codeman-pi-projects/GBA_SPi_Board/GBA SP schematic.pdf

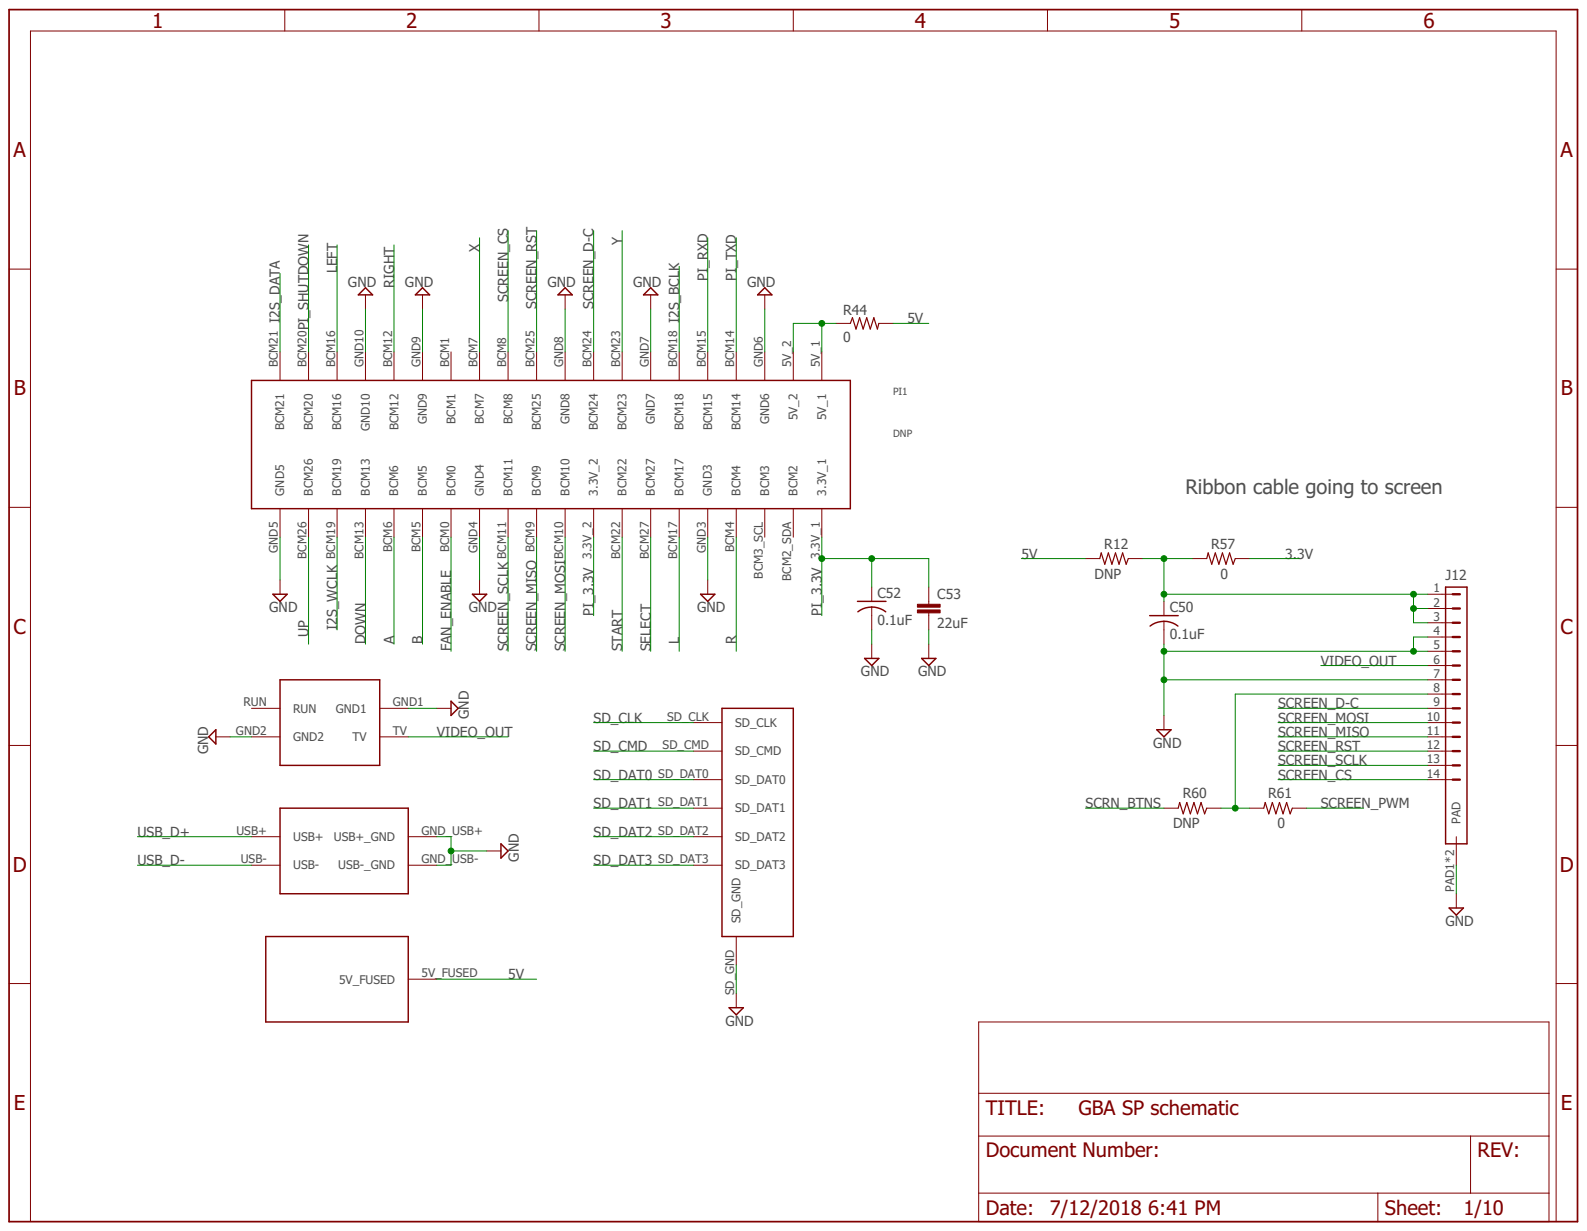
[picture p1: page 1]

Ribbon cable going to screen

Document Number: | REV:

Date: 7/12/2018 6:41 PM | Sheet: 1/10

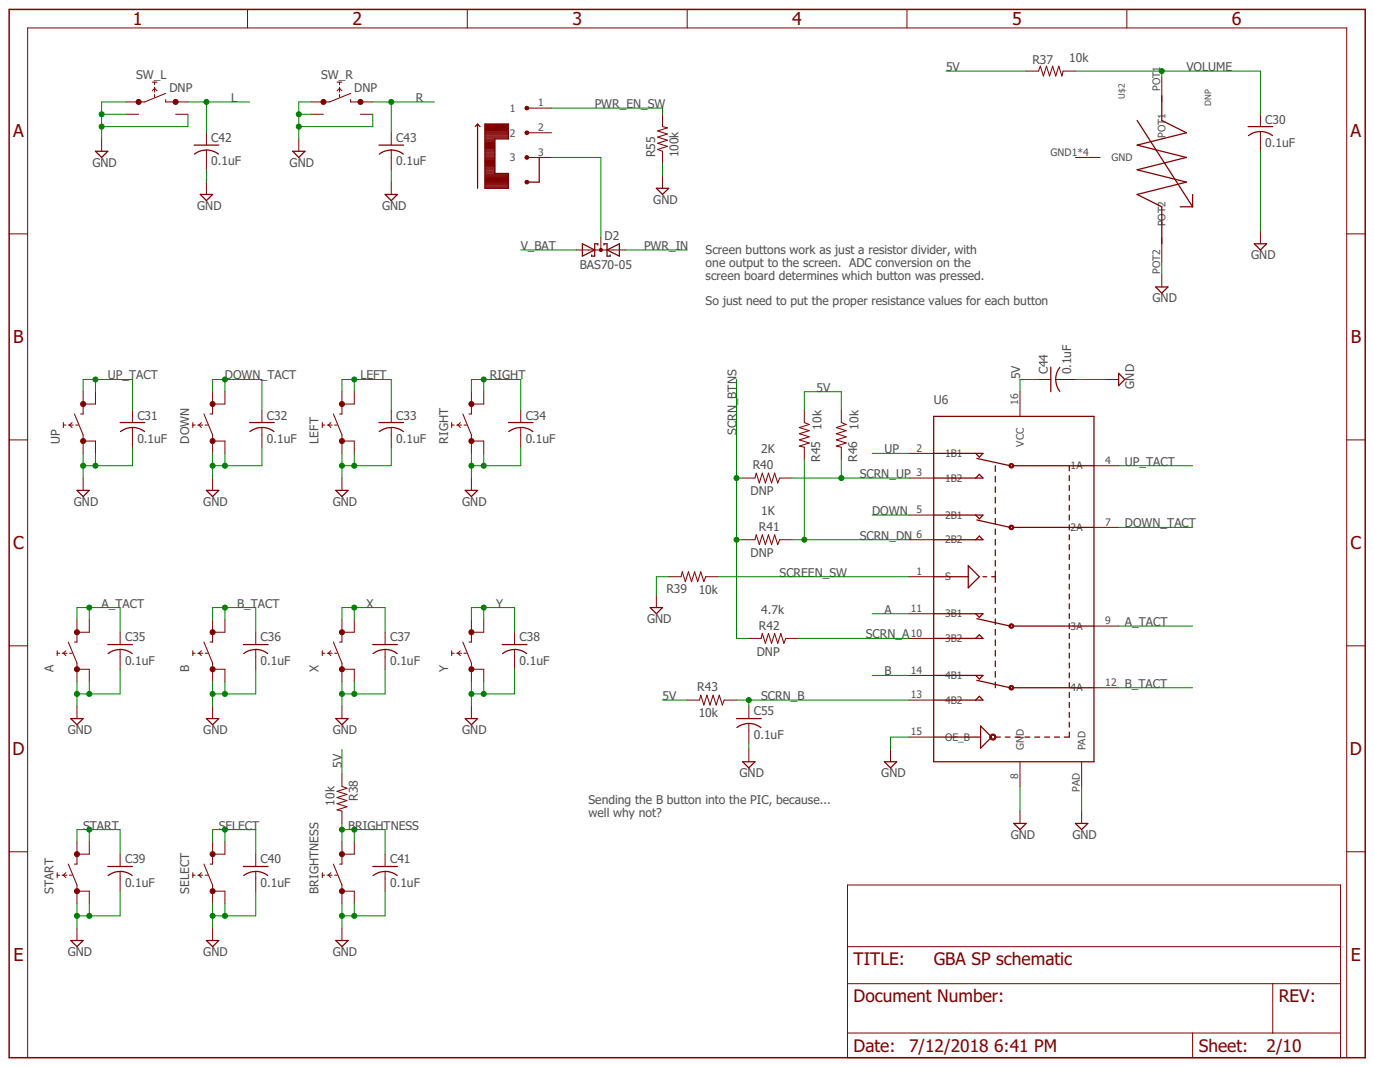
[picture p2: page 2]

Screen buttons work as just a resistor divider, with
one output to the screen. ADC conversion on the
screen board determines which button was pressed. So just need to put the proper resistance values for each button

Sending the B button into the PIC, because... well why not?

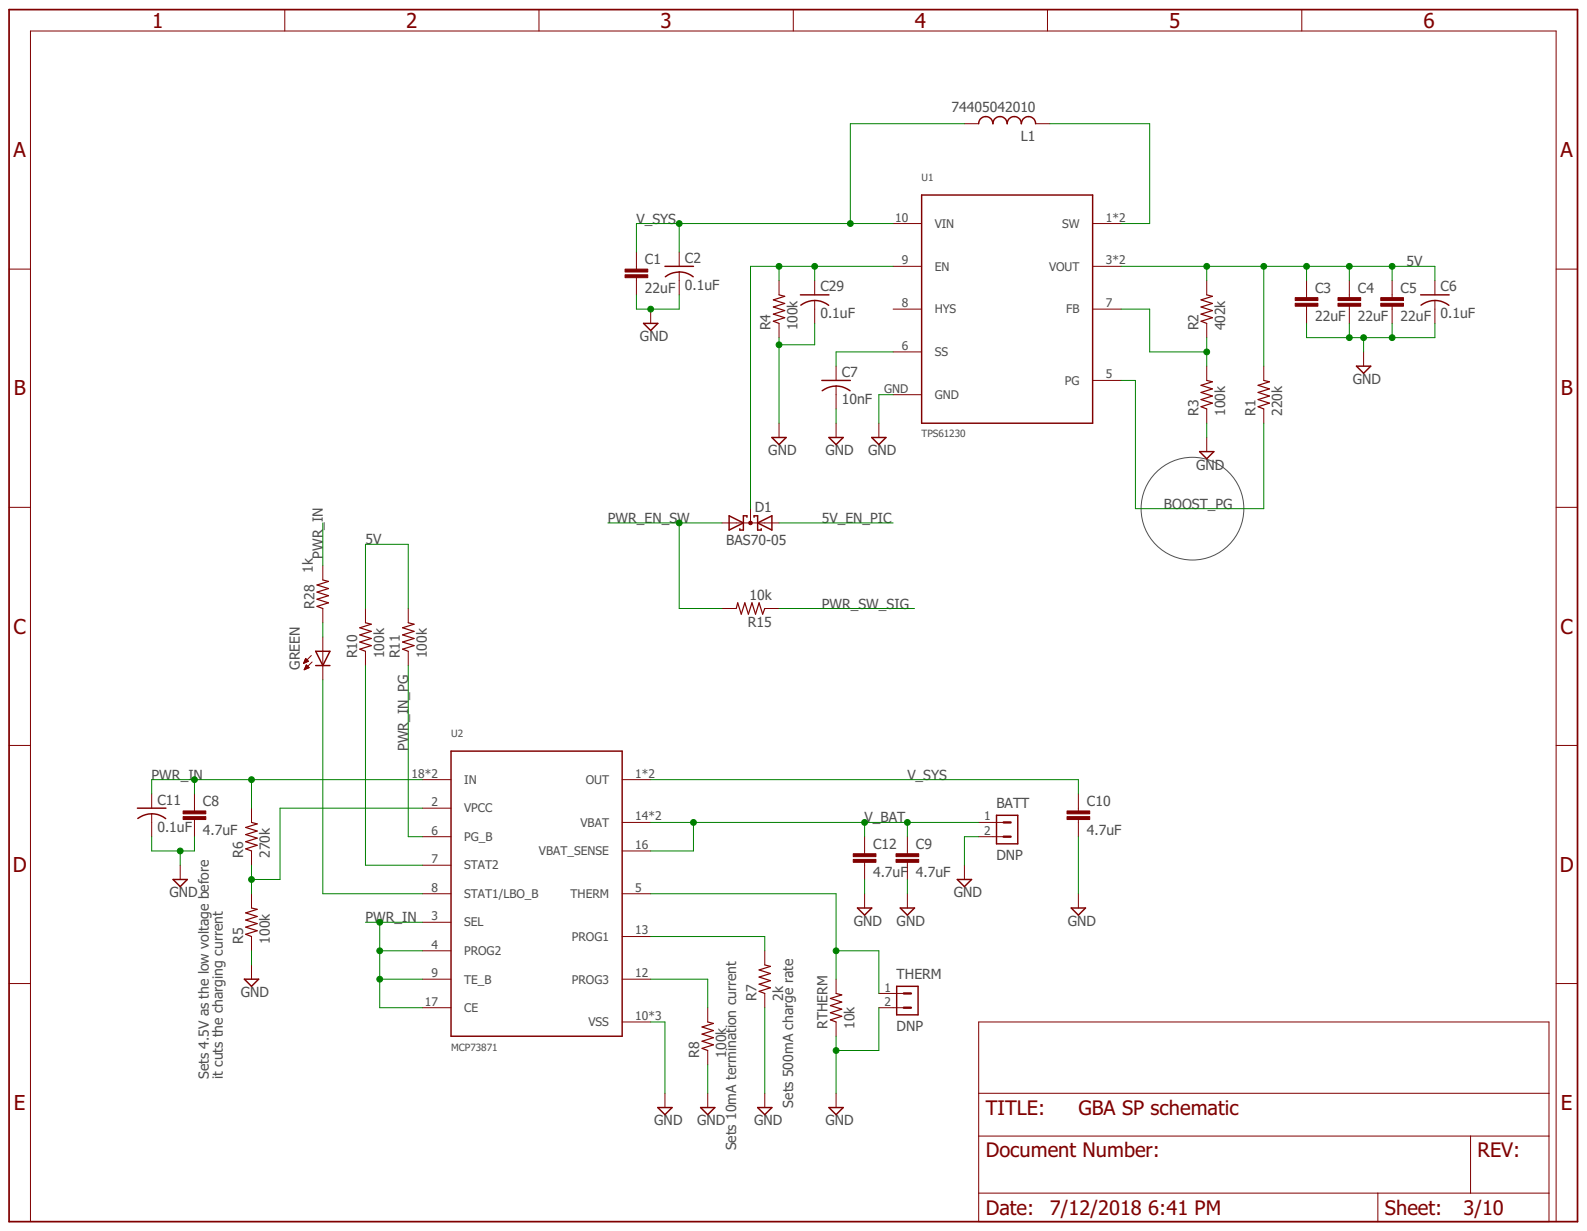
[picture p3: page 3]

Sets 4.5V as the low voltage before

it cuts the charging current

Sets 500mA charge rate Sets 10mA termination current

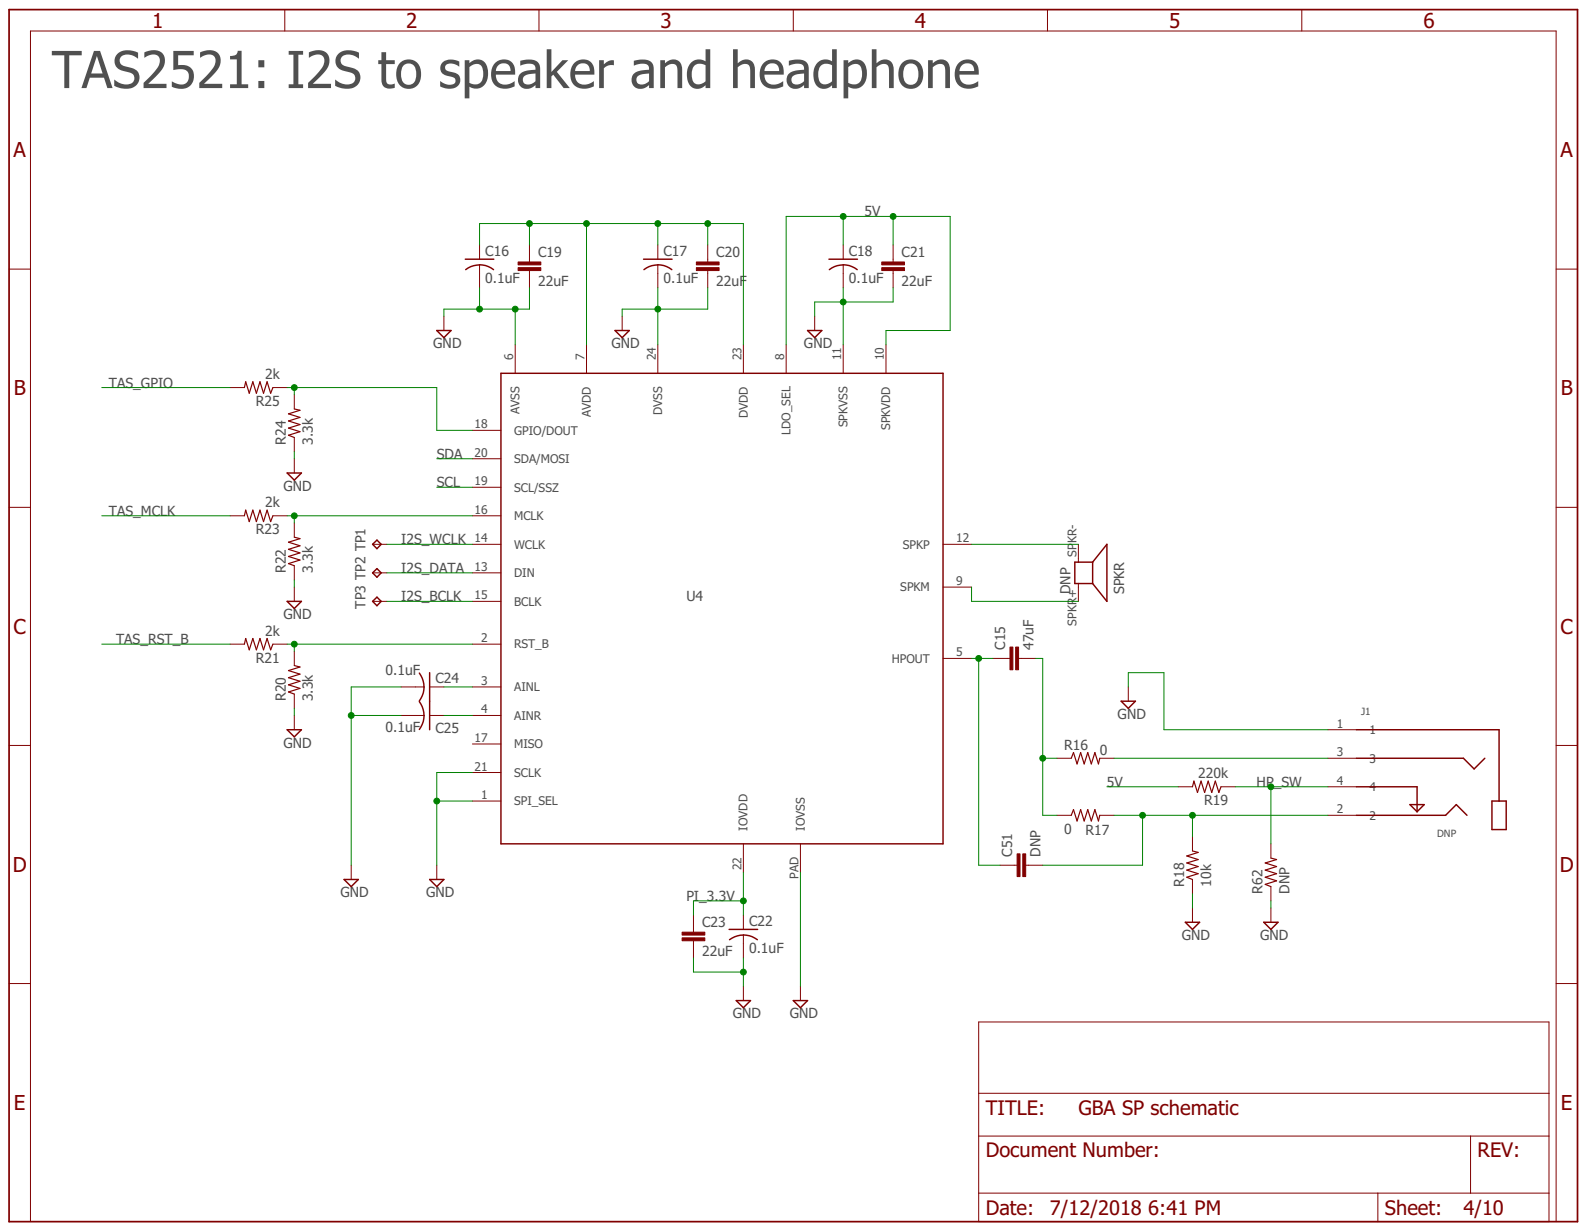
[picture p4: page 4]

TAS2521: I2S to speaker and headphone

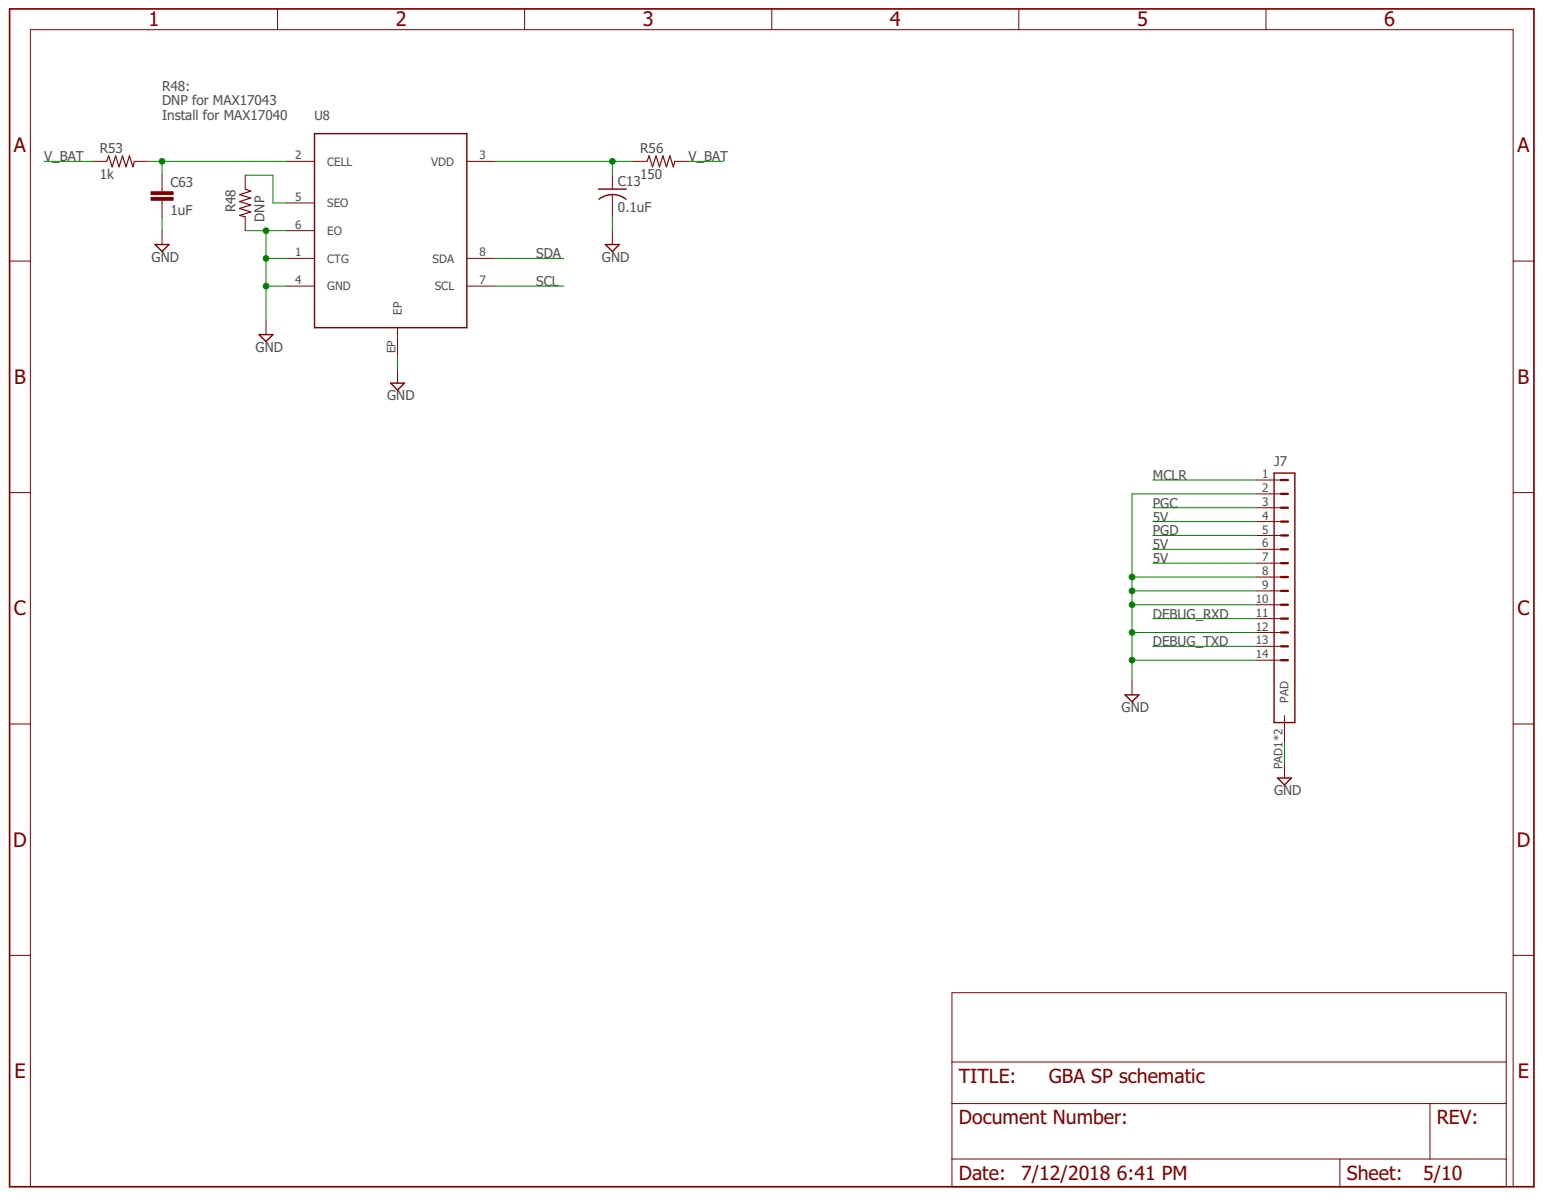
[picture p5: page 5]

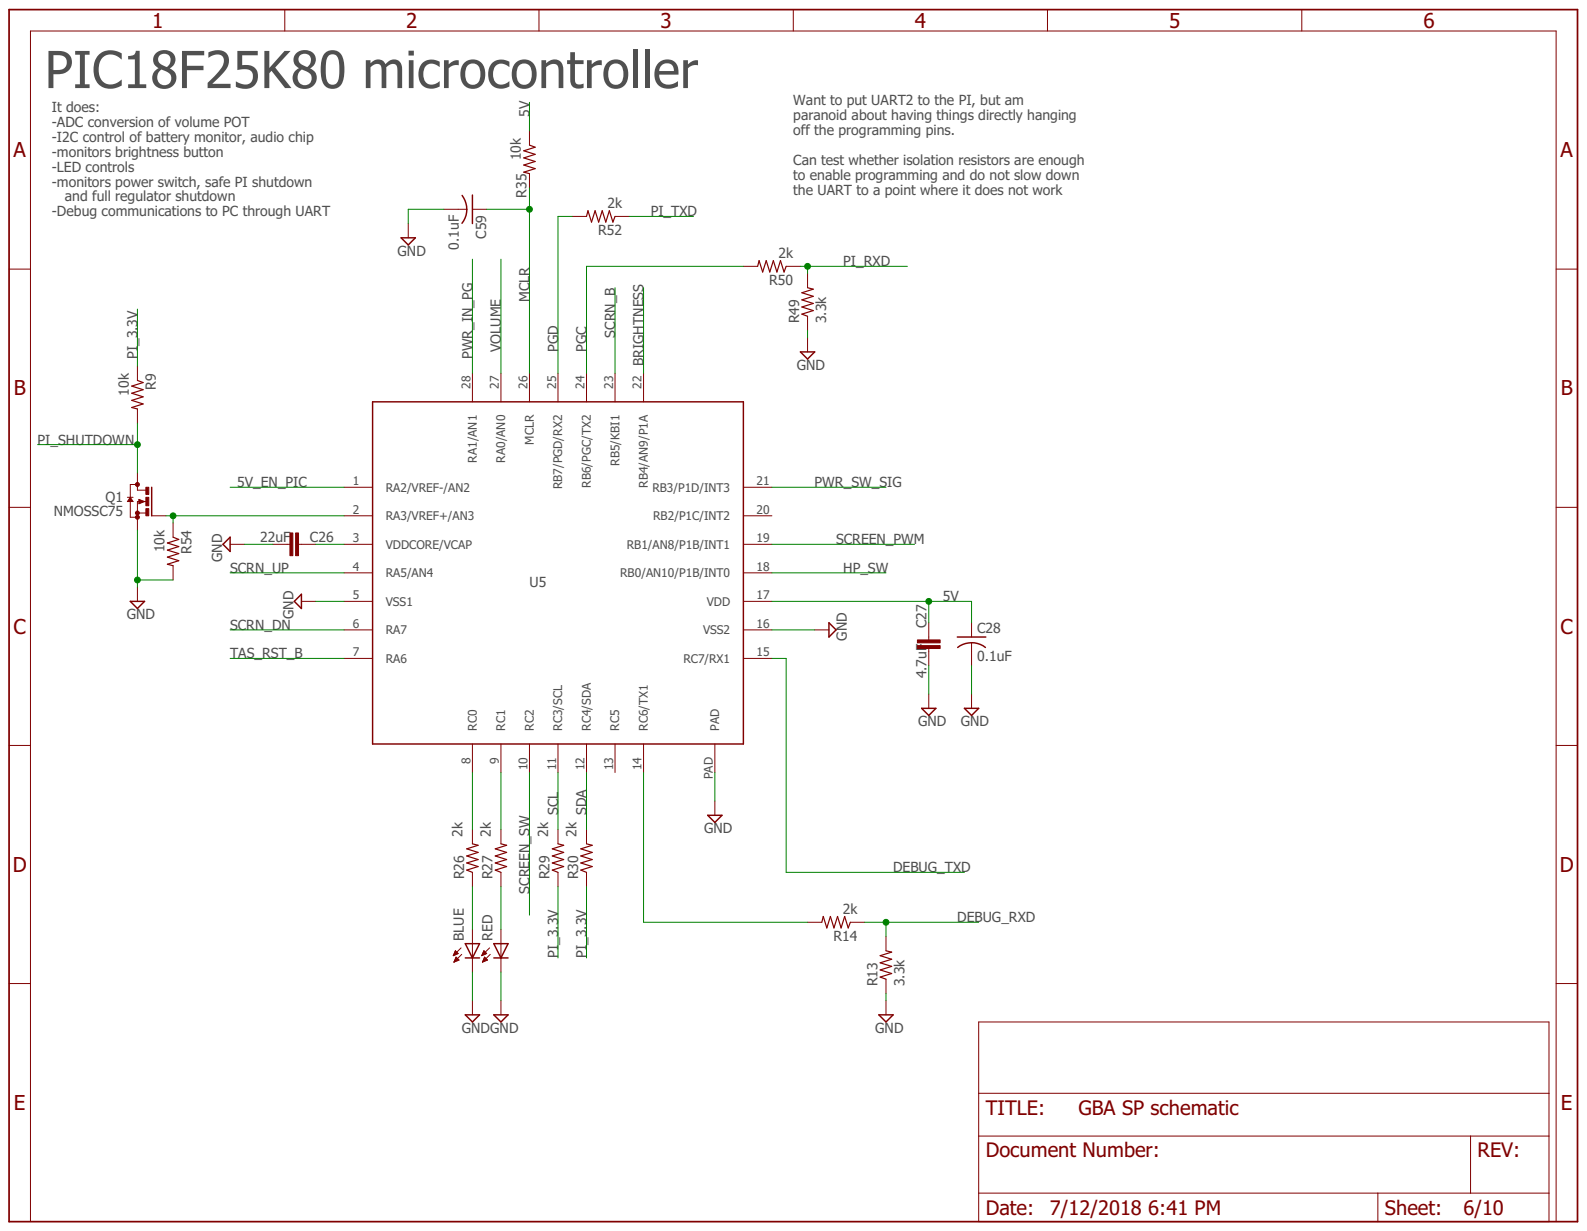
[picture p6: page 6]

Want to put UART2 to the PI, but am
paranoid about having things directly hanging
off the programming pins. Can test whether isolation resistors are enough

It does: -ADC conversion of volume POT

-I2C control of battery monitor, audio chip

-monitors brightness button
-LED controls
-monitors power switch, safe PI shutdown
and full regulator shutdown
-Debug communications to PC through UART

to enable programming and do not slow down
the UART to a point where it does not work

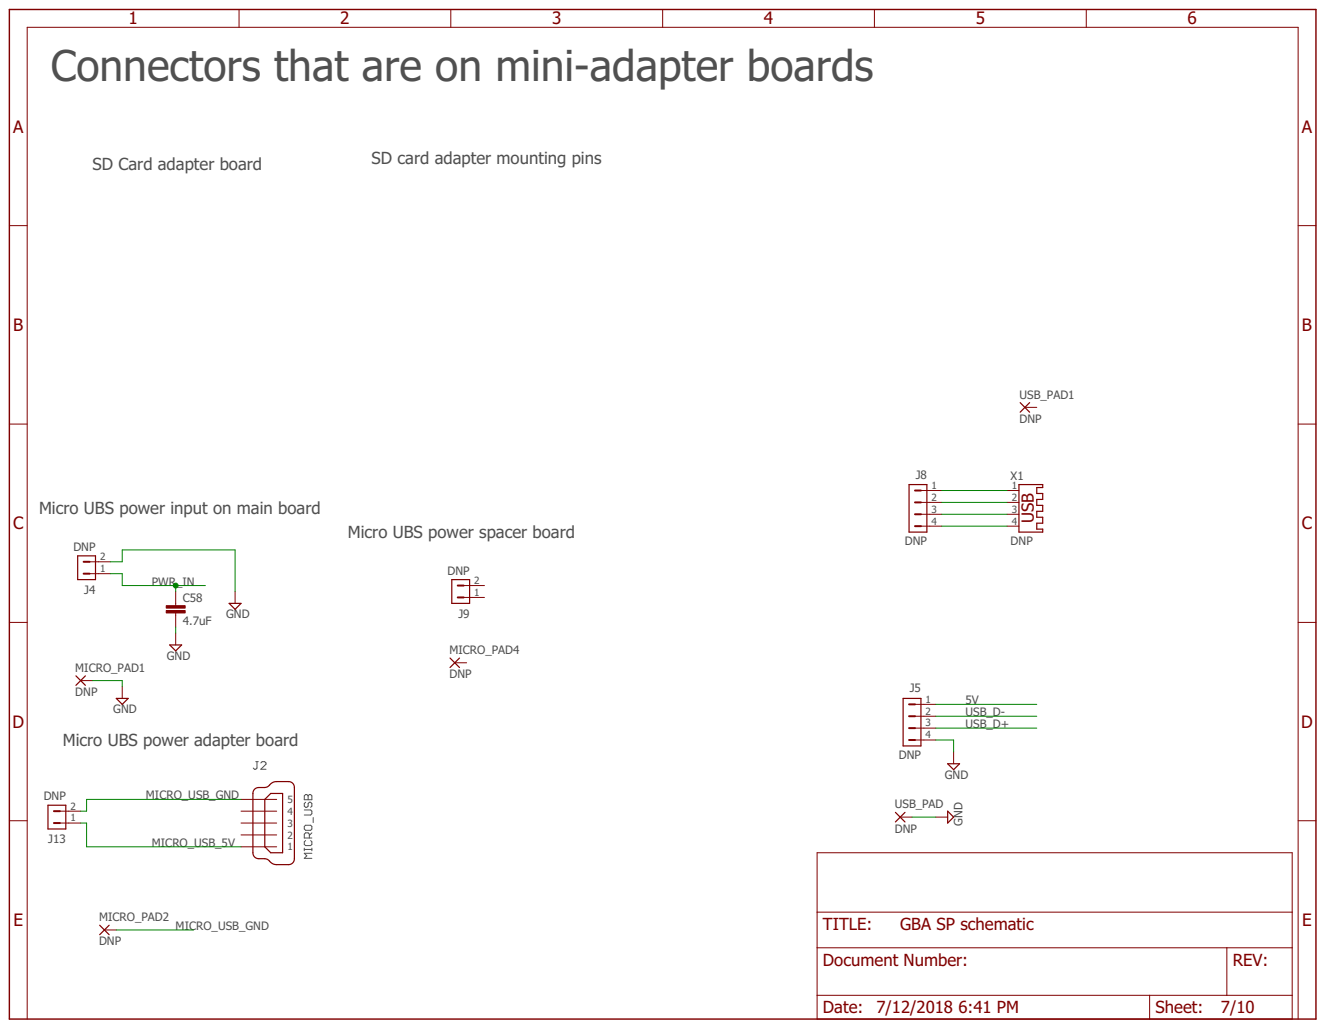
[picture p7: page 7]

Connectors that are on mini-adapter boards

Micro UBS power input on main board

Micro UBS power spacer board

Micro UBS power adapter board

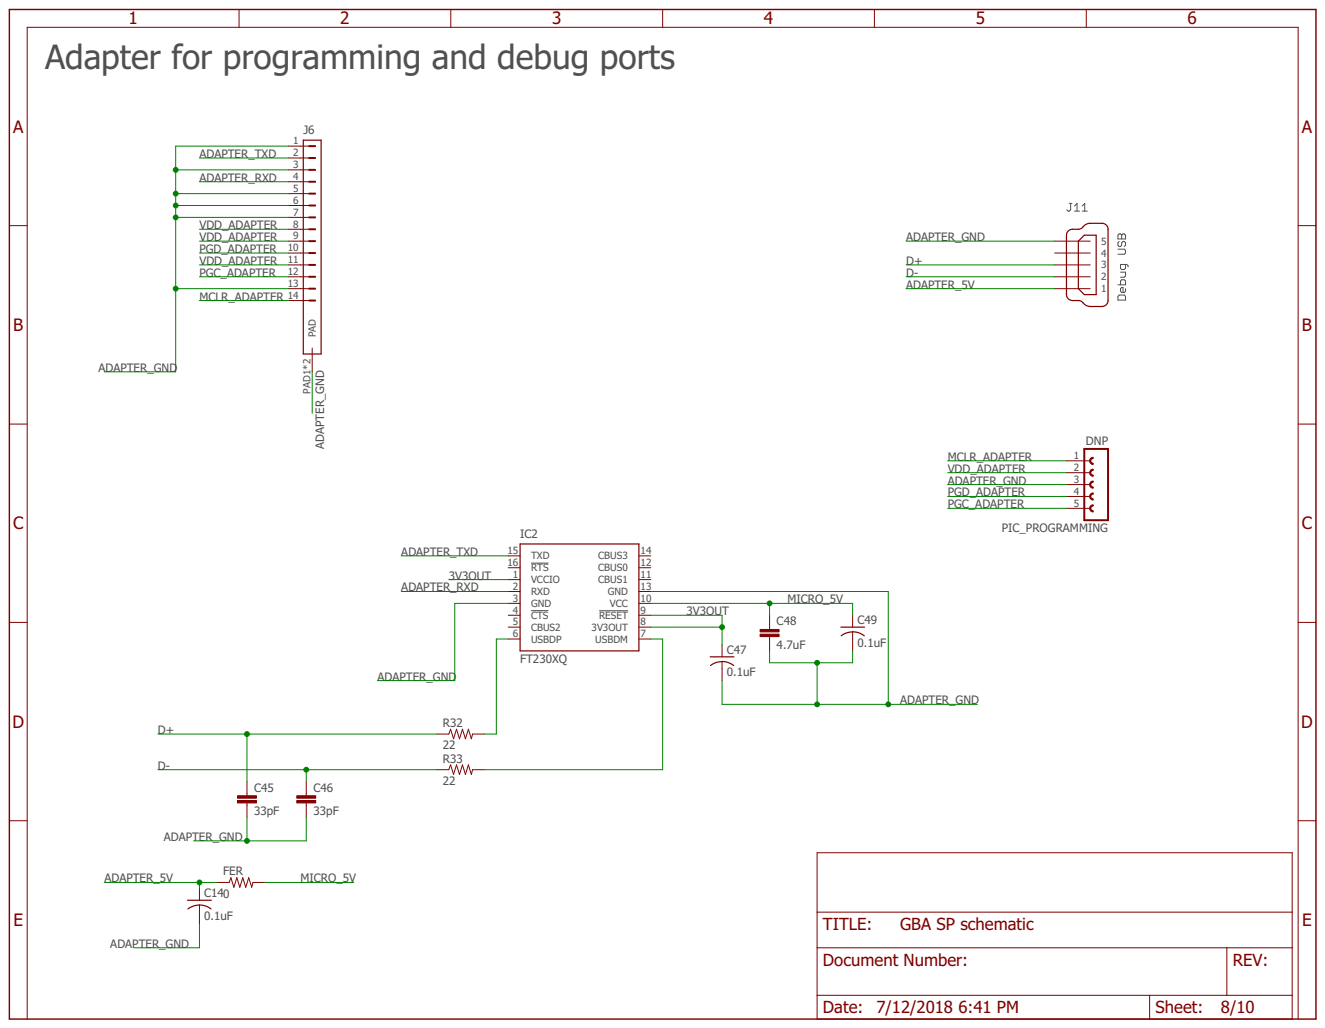
[picture p8: page 8]

Adapter for programming and debug ports

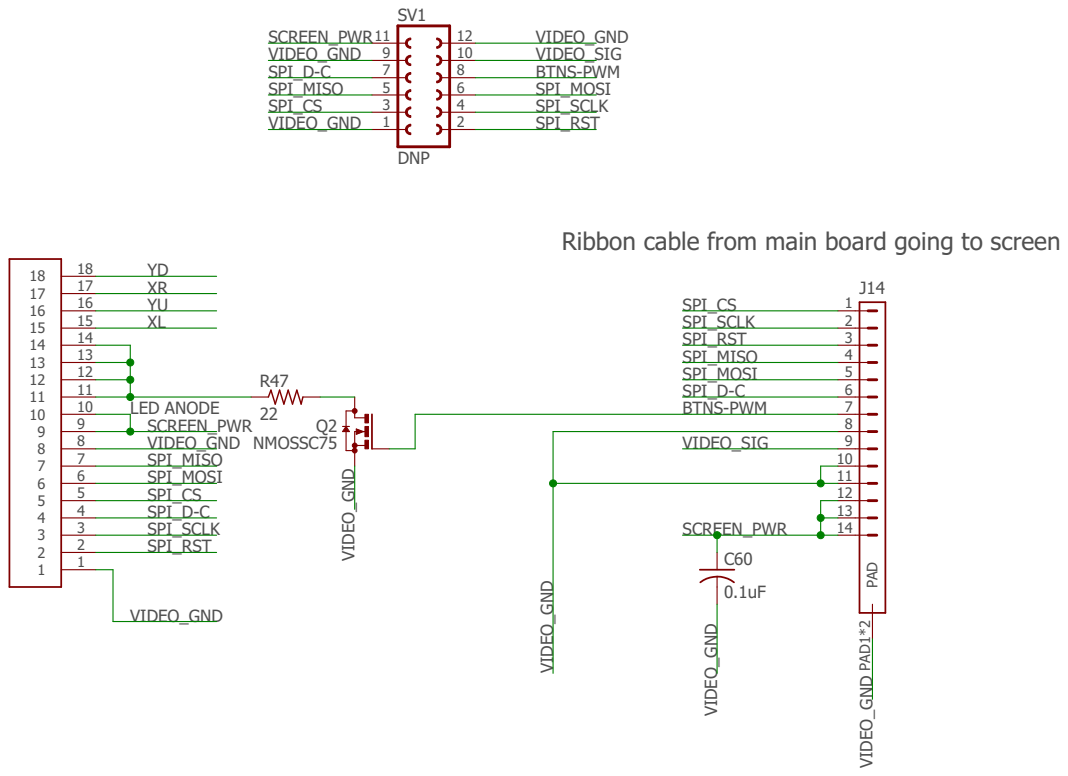
[picture p9: page 9]

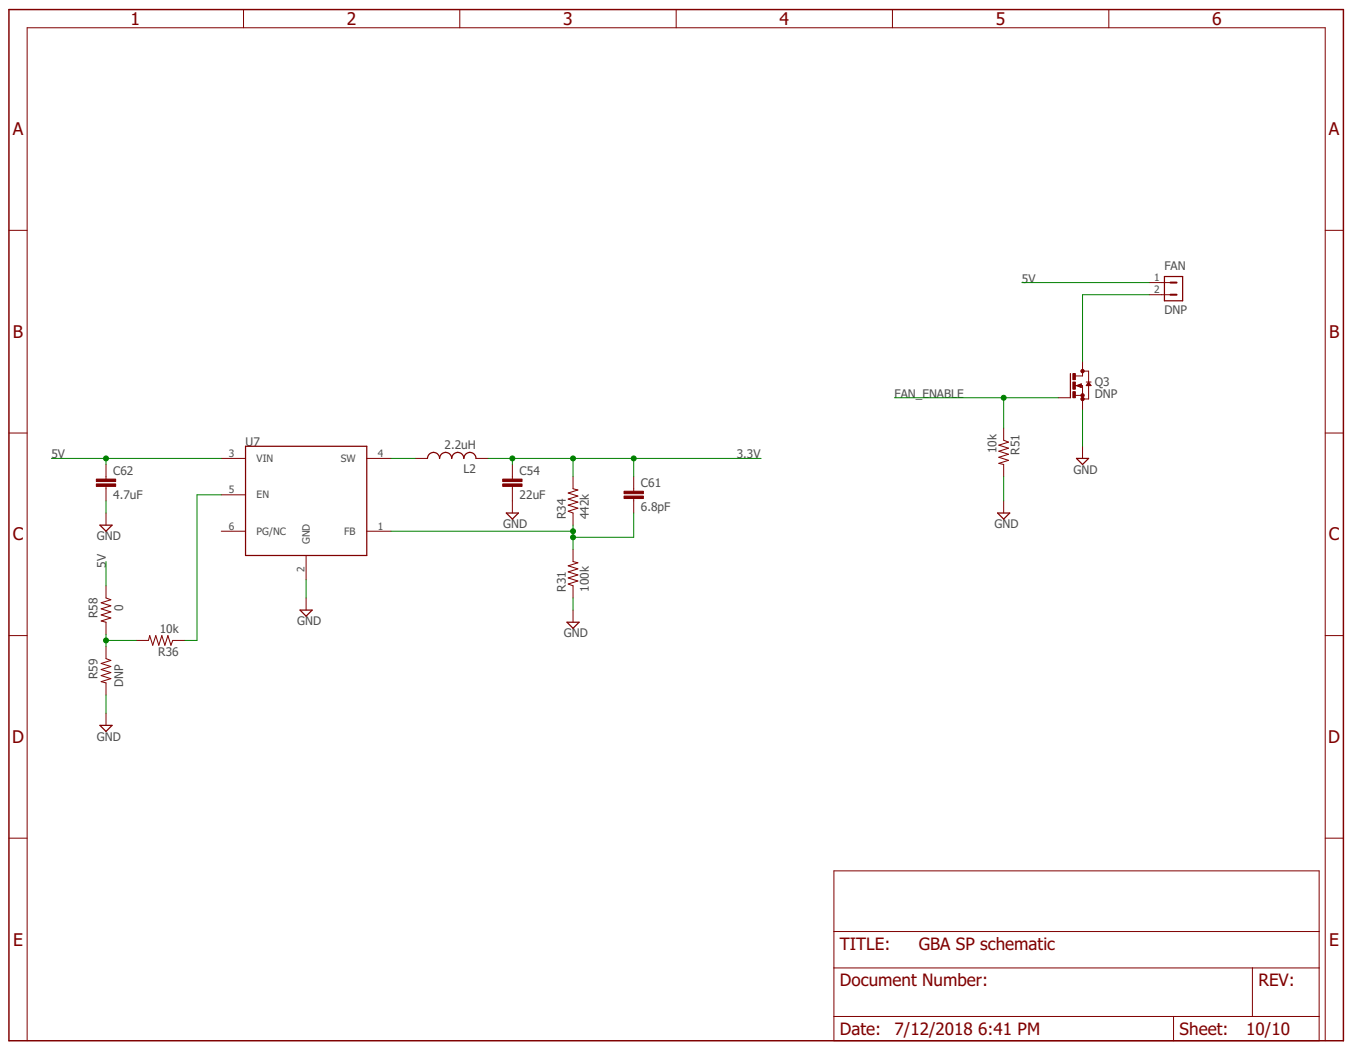
[picture p10: page 10]
