codeman-pi-projects/GBA_SPi_Board/GBA SP schematic.brd

## EAGLE design GBA SP schematic.brd (2018-10-27)

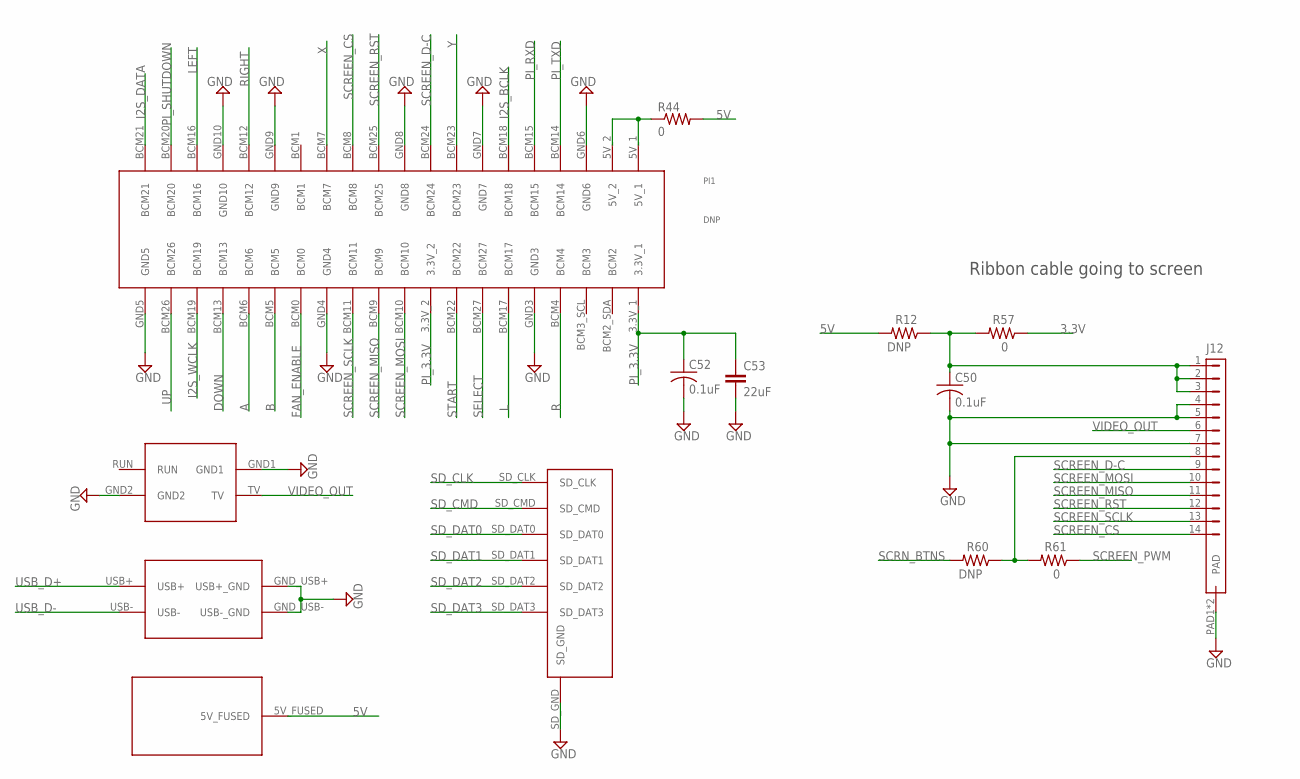
[picture p11: schematic GBA SP schematic.sch, sheet 1]

Parts:
C50, C52: 0.1uF; 0402_REAL; MPN CC0603ZRY5V9BB104; DIGIKEY 311-1343-1-ND
C53: 22uF; C0805; MPN LMK212BBJ226MG-T; DIGIKEY 587-5464-1-ND
J12: FPC_14; MPN 5051101492; DIGIKEY WM12370CT-ND
PI1: DNP; PI-ZERO
R12: DNP; R0603
R44: 0; R0805
R57: 0; R0603
R60: DNP; 0402_REAL
R61: 0; 0402_REAL

Connections:
3.3V: R57.1; also elsewhere on the board
5V: PI1.5V_FUSED, R12.2, R44.2; also elsewhere on the board
A: PI1.BCM6; also elsewhere on the board
B: PI1.BCM5; also elsewhere on the board
DOWN: PI1.BCM13; also elsewhere on the board
FAN_ENABLE: PI1.BCM0; also elsewhere on the board
GND: C50.2, C52.2, C53.2, J12.4, J12.5, J12.7, J12.PAD1 (PAD), J12.PAD2 (PAD), PI1.GND1, PI1.GND2, PI1.GND3, PI1.GND4, PI1.GND5, PI1.GND6, PI1.GND7, PI1.GND8, PI1.GND9, PI1.GND10, PI1.GND_USB+ (USB+_GND), PI1.GND_USB- (USB-_GND), PI1.SD_GND; also elsewhere on the board
I2S_BCLK: PI1.BCM18; also elsewhere on the board
I2S_DATA: PI1.BCM21; also elsewhere on the board
I2S_WCLK: PI1.BCM19; also elsewhere on the board
L: PI1.BCM17; also elsewhere on the board
LEFT: PI1.BCM16; also elsewhere on the board
unnamed: PI1.5V_1, PI1.5V_2, R44.1
unnamed: J12.8, R60.1, R61.2
unnamed: C50.1, J12.1, J12.2, J12.3, R12.1, R57.2
PI_3.3V: C52.1, C53.1, PI1.3.3V_1, PI1.3.3V_2; also elsewhere on the board
PI_RXD: PI1.BCM15; also elsewhere on the board
PI_SHUTDOWN: PI1.BCM20; also elsewhere on the board
PI_TXD: PI1.BCM14; also elsewhere on the board
R: PI1.BCM4; also elsewhere on the board
RIGHT: PI1.BCM12; also elsewhere on the board
SCREEN_CS: J12.14, PI1.BCM8
SCREEN_D-C: J12.9, PI1.BCM24
SCREEN_MISO: J12.11, PI1.BCM9
SCREEN_MOSI: J12.10, PI1.BCM10
SCREEN_PWM: R61.1; also elsewhere on the board
SCREEN_RST: J12.12, PI1.BCM25
SCREEN_SCLK: J12.13, PI1.BCM11
SCRN_BTNS: R60.2; also elsewhere on the board
SD_CLK: PI1.SD_CLK
SD_CMD: PI1.SD_CMD
SD_DAT0: PI1.SD_DAT0
SD_DAT1: PI1.SD_DAT1
SD_DAT2: PI1.SD_DAT2
SD_DAT3: PI1.SD_DAT3
SELECT: PI1.BCM27; also elsewhere on the board
START: PI1.BCM22; also elsewhere on the board
UP: PI1.BCM26; also elsewhere on the board
USB_D+: PI1.USB+; also elsewhere on the board
USB_D-: PI1.USB-; also elsewhere on the board
VIDEO_OUT: J12.6, PI1.TV
X: PI1.BCM7; also elsewhere on the board
Y: PI1.BCM23; also elsewhere on the board

Notes on the sheet:
Ribbon cable going to screen

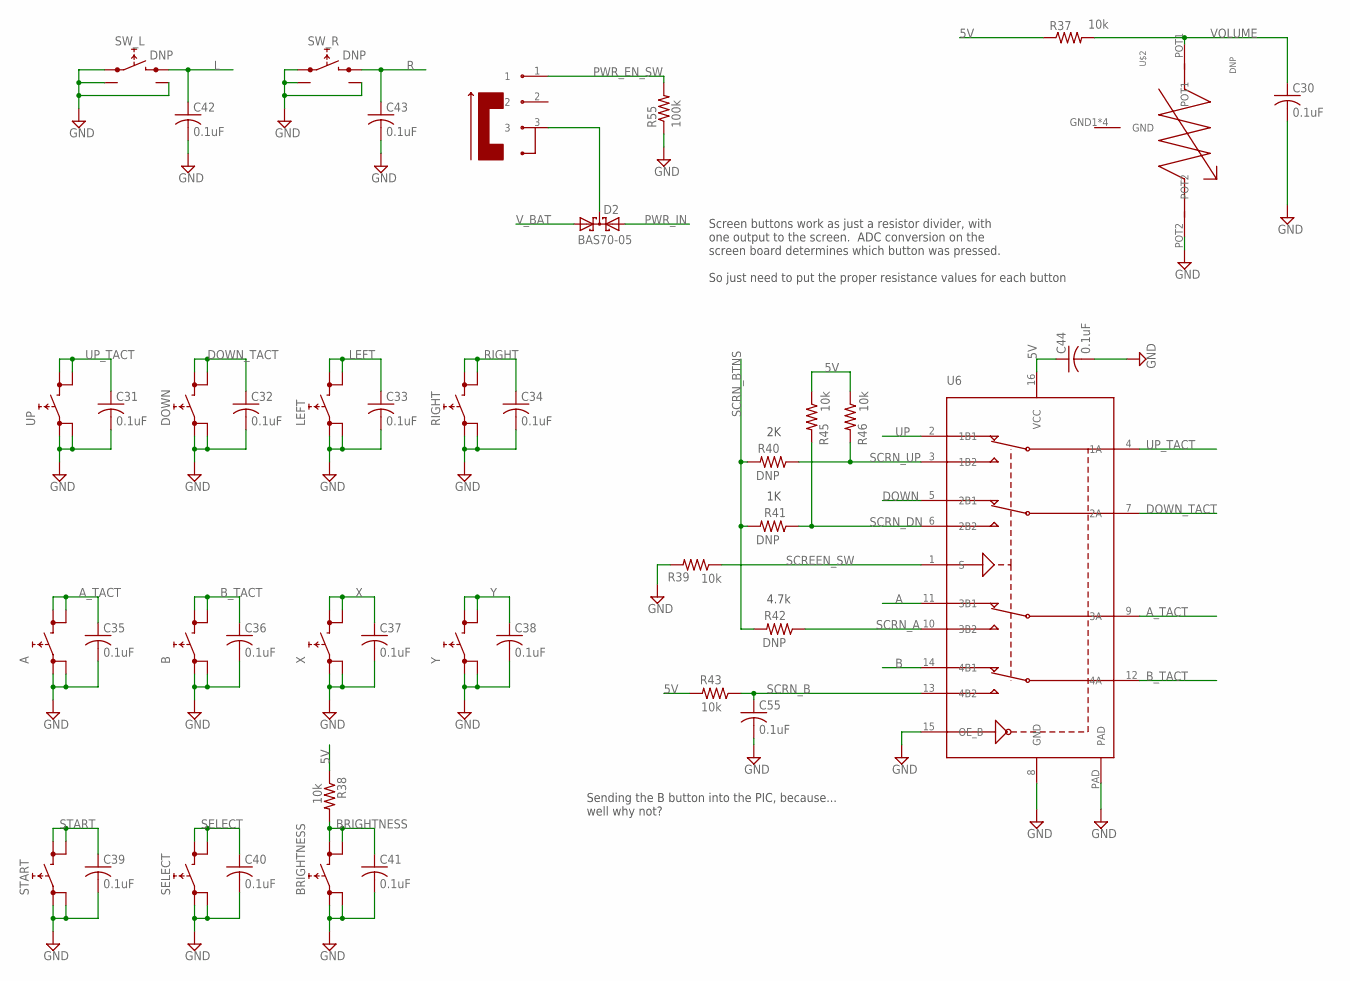
[picture p12: schematic GBA SP schematic.sch, sheet 2]

Parts:
A: TACTILEGBA_SP; GBA_SP_TACT; MPN SKRRAAE010; MOUSER 688-SKRRAA
B: TACTILEGBA_SP; GBA_SP_TACT; MPN SKRRAAE010; MOUSER 688-SKRRAA
BRIGHTNESS: TACTILE; TL3315; MPN TL3315NF160Q; DIGIKEY EG4621CT-ND
C30, C31, C32, C33, C34, C35, C36, C37, C38, C39, C40, C41, C42, C43, C44, C55: 0.1uF; 0402_REAL; MPN CC0603ZRY5V9BB104; DIGIKEY 311-1343-1-ND
D2: BAS70-05; SOT23; MPN BAS70-05-E3-08; DIGIKEY BAS70-05-E3-08CT-ND
DOWN: TACTILEGBA_SP; GBA_SP_TACT; MPN SKRRAAE010; MOUSER 688-SKRRAA
LEFT: TACTILEGBA_SP; GBA_SP_TACT; MPN SKRRAAE010; MOUSER 688-SKRRAA
R37, R38, R39, R43, R45, R46: 10k; 0402_REAL
R40: DNP; 0402_REAL; MPN ERJ-2RKF2001X; DIGIKEY P2.00KLCT-ND
R41, R42: DNP; 0402_REAL
R55: 100k; 0402_REAL; MPN RC0402FR-07100KL; DIGIKEY 311-100KLRCT-ND
RIGHT: TACTILEGBA_SP; GBA_SP_TACT; MPN SKRRAAE010; MOUSER 688-SKRRAA
SELECT: TACTILE; TL3315; MPN TL3315NF160Q; DIGIKEY EG4621CT-ND
START: TACTILE; TL3315; MPN TL3315NF160Q; DIGIKEY EG4621CT-ND
SW_L: DNP; GBA-SHOULDER-SW
SW_R: DNP; GBA-SHOULDER-SW
U6: SN74CBT3257C; VQFN16; MPN SN74CBT3257CRGYR; DIGIKEY 296-19212-1-ND
U$1: CSS-1210; MPN CSS-1210TB
U$2: DNP; GBA-POT
UP: TACTILEGBA_SP; GBA_SP_TACT; MPN SKRRAAE010; MOUSER 688-SKRRAA
X: TACTILEGBA_SP; GBA_SP_TACT; MPN SKRRAAE010; MOUSER 688-SKRRAA
Y: TACTILEGBA_SP; GBA_SP_TACT; MPN SKRRAAE010; MOUSER 688-SKRRAA

Connections:
5V: C44.1, R37.1, R38.1, R43.2, R45.1, R46.1, U6.16 (VCC); also elsewhere on the board
A: U6.11 (3B1); also elsewhere on the board
A_TACT: A.2 (3), A.4, C35.1, U6.9 (3A)
B: U6.14 (4B1); also elsewhere on the board
BRIGHTNESS: BRIGHTNESS.3, BRIGHTNESS.4, C41.1, R38.2; also elsewhere on the board
B_TACT: B.2 (3), B.4, C36.1, U6.12 (4A)
DOWN: U6.5 (2B1); also elsewhere on the board
DOWN_TACT: C32.1, DOWN.2 (3), DOWN.4, U6.7 (2A)
GND: A.1, A.3 (2), B.1, B.3 (2), BRIGHTNESS.1, BRIGHTNESS.2, C30.2, C31.2, C32.2, C33.2, C34.2, C35.2, C36.2, C37.2, C38.2, C39.2, C40.2, C41.2, C42.2, C43.2, C44.2, C55.2, DOWN.1, DOWN.3 (2), LEFT.1, LEFT.3 (2), R39.2, R55.1, RIGHT.1, RIGHT.3 (2), SELECT.1, SELECT.2, START.1, START.2, SW_L.A, SW_L.GND1, SW_L.GND2, SW_R.A, SW_R.GND1, SW_R.GND2, U6.8 (GND), U6.15 (OE_B), U6.PAD, U$2.POT2, UP.1, UP.3 (2), X.1, X.3 (2), Y.1, Y.3 (2); also elsewhere on the board
L: C42.1, SW_L.B; also elsewhere on the board
LEFT: C33.1, LEFT.2 (3), LEFT.4; also elsewhere on the board
unnamed: D2.3 (C), U$1.3
PWR_EN_SW: R55.2, U$1.1; also elsewhere on the board
PWR_IN: D2.2 (A2); also elsewhere on the board
R: C43.1, SW_R.B; also elsewhere on the board
RIGHT: C34.1, RIGHT.2 (3), RIGHT.4; also elsewhere on the board
SCREEN_SW: R39.1, U6.1 (S); also elsewhere on the board
SCRN_A: R42.1, U6.10 (3B2)
SCRN_B: C55.1, R43.1, U6.13 (4B2); also elsewhere on the board
SCRN_BTNS: R40.2, R41.2, R42.2; also elsewhere on the board
SCRN_DN: R41.1, R45.2, U6.6 (2B2); also elsewhere on the board
SCRN_UP: R40.1, R46.2, U6.3 (1B2); also elsewhere on the board
SELECT: C40.1, SELECT.3, SELECT.4; also elsewhere on the board
START: C39.1, START.3, START.4; also elsewhere on the board
UP: U6.2 (1B1); also elsewhere on the board
UP_TACT: C31.1, U6.4 (1A), UP.2 (3), UP.4
VOLUME: C30.1, R37.2, U$2.POT1; also elsewhere on the board
V_BAT: D2.1 (A1); also elsewhere on the board
X: C37.1, X.2 (3), X.4; also elsewhere on the board
Y: C38.1, Y.2 (3), Y.4; also elsewhere on the board

Notes on the sheet:
Screen buttons work as just a resistor divider, with one output to the screen. ADC conversion on the screen board determines which button was pressed. So just need to put the proper resistance values for each button
Sending the B button into the PIC, because... well why not?
4.7k

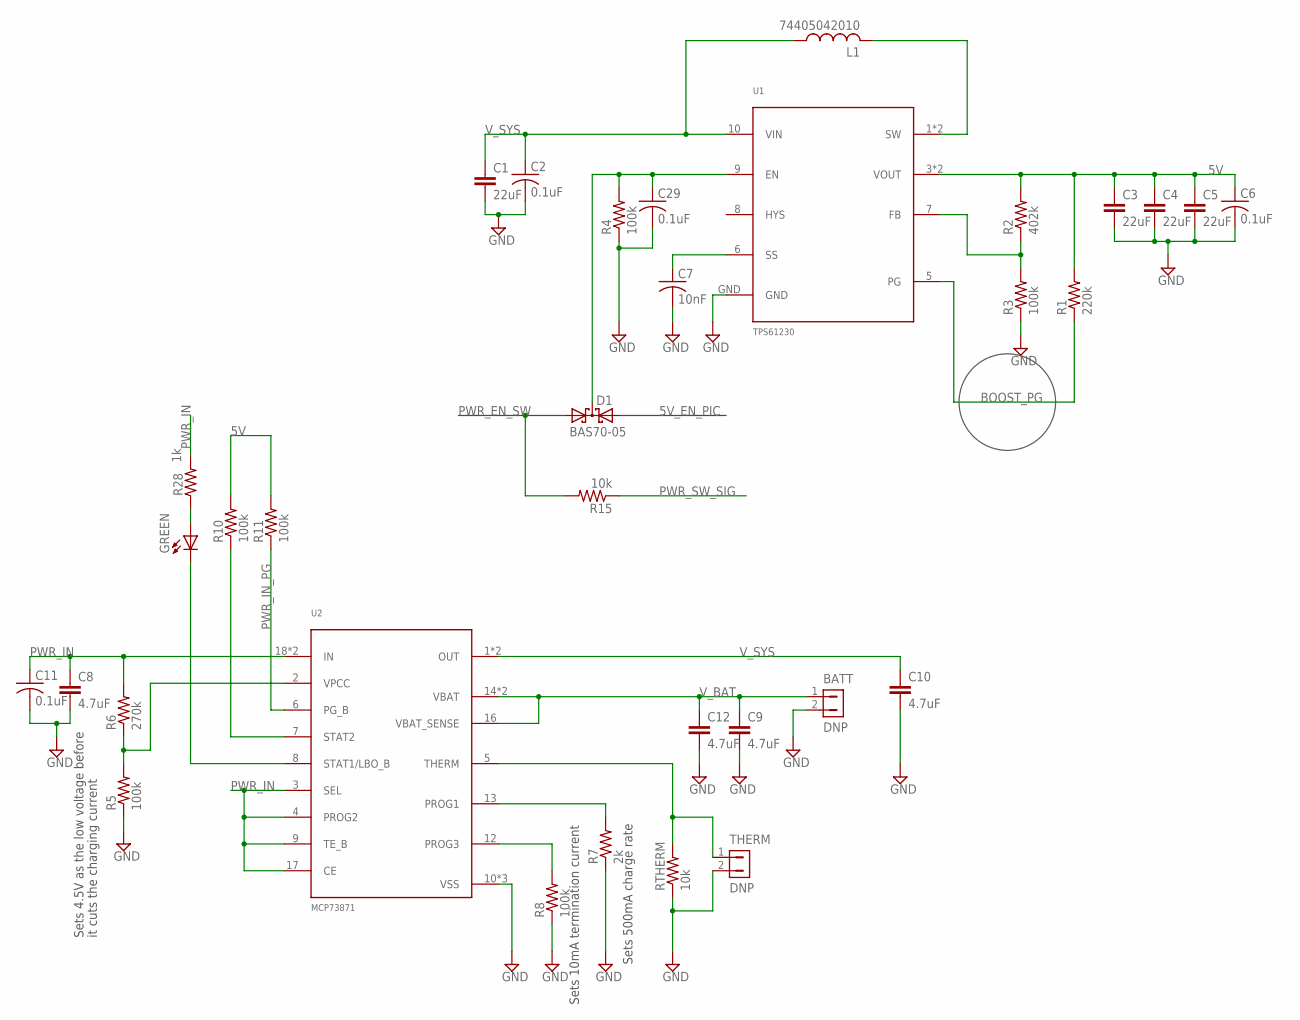
[picture p13: schematic GBA SP schematic.sch, sheet 3]

Parts:
BATT: DNP; HEADER-1X2
C1, C3, C4, C5: 22uF; C0805; MPN LMK212BBJ226MG-T; DIGIKEY 587-5464-1-ND
C2, C6, C11, C29: 0.1uF; 0402_REAL; MPN CC0603ZRY5V9BB104; DIGIKEY 311-1343-1-ND
C7: 10nF; 0402_REAL; MPN GRM155R71H103KA88D; DIGIKEY 490-4516-1-ND
C8, C9, C10, C12: 4.7uF; C0603; MPN CC0603KRX5R6BB475; DIGIKEY 311-1455-1-ND
D1: BAS70-05; SOT23; MPN BAS70-05-E3-08; DIGIKEY BAS70-05-E3-08CT-ND
GREEN: LEDCHIP-LED0603; CHIP-LED0603; MPN LTST-C191KGKT; DIGIKEY 160-1446-1-ND
L1: 74405042010; XFL4020-102MEB; MPN 74405042010
R1: 220k; R0603
R2: 402k; 0402_REAL; MPN RC0402FR-07402KL; DIGIKEY YAG3151CT-ND
R3, R4, R5, R8, R10, R11: 100k; 0402_REAL; MPN RC0402FR-07100KL; DIGIKEY 311-100KLRCT-ND
R6: 270k; R0603; MPN RC0402JR-07270KL; DIGIKEY 311-270KJRCT-ND
R7: 2k; 0402_REAL; MPN ERJ-2RKF2001X; DIGIKEY P2.00KLCT-ND
R15: 10k; 0402_REAL
R28: 1k; 0402_REAL
RTHERM: 10k; 0402_REAL
THERM: DNP; DF13-2_THIN
U1: TPS61230; VSON10; MPN TPS61230DRCR; DIGIKEY 296-37761-1-ND
U2: MCP73871; QFN20; MPN MCP73871-2AAI/ML; DIGIKEY MCP73871-2AAI/ML-ND

Connections:
5V: C3.1, C4.1, C5.1, C6.1, R1.2, R2.2, R10.2, R11.2, U1.3 (VOUT), U1.4 (VOUT); also elsewhere on the board
5V_EN_PIC: D1.2 (A2); also elsewhere on the board
BOOST_PG: R1.1, U1.5 (PG)
GND: BATT.2, C1.2, C2.2, C3.2, C4.2, C5.2, C6.2, C7.2, C8.2, C9.2, C10.2, C11.2, C12.2, C29.2, R3.1, R4.1, R5.1, R7.1, R8.1, RTHERM.1, THERM.2, U1.GND, U2.10 (VSS), U2.11 (VSS), U2.PAD (VSS); also elsewhere on the board
unnamed: C29.1, D1.3 (C), R4.2, U1.9 (EN)
unnamed: L1.2, U1.1 (SW), U1.2 (SW)
unnamed: R2.1, R3.2, U1.7 (FB)
unnamed: R7.2, U2.13 (PROG1)
unnamed: R5.2, R6.1, U2.2 (VPCC)
unnamed: C7.1, U1.6 (SS)
unnamed: R8.2, U2.12 (PROG3)
unnamed: RTHERM.2, THERM.1, U2.5 (THERM)
unnamed: GREEN.A, R28.1
PWR_EN_SW: D1.1 (A1), R15.2; also elsewhere on the board
PWR_IN: C8.1, C11.1, R6.2, R28.2, U2.3 (SEL), U2.4 (PROG2), U2.9 (TE_B), U2.17 (CE), U2.18 (IN), U2.19 (IN); also elsewhere on the board
PWR_IN_PG: R11.1, U2.6 (PG_B); also elsewhere on the board
PWR_SW_SIG: R15.1; also elsewhere on the board
STAT1: GREEN.C, U2.8 (STAT1/LBO_B)
STAT2: R10.1, U2.7 (STAT2)
V_BAT: BATT.1, C9.1, C12.1, U2.14 (VBAT), U2.15 (VBAT), U2.16 (VBAT_SENSE); also elsewhere on the board
V_SYS: C1.1, C2.1, C10.1, L1.1, U1.10 (VIN), U2.1 (OUT), U2.20 (OUT)

Notes on the sheet:
Sets 4.5V as the low voltage before
it cuts the charging current
Sets 500mA charge rate
Sets 10mA termination current

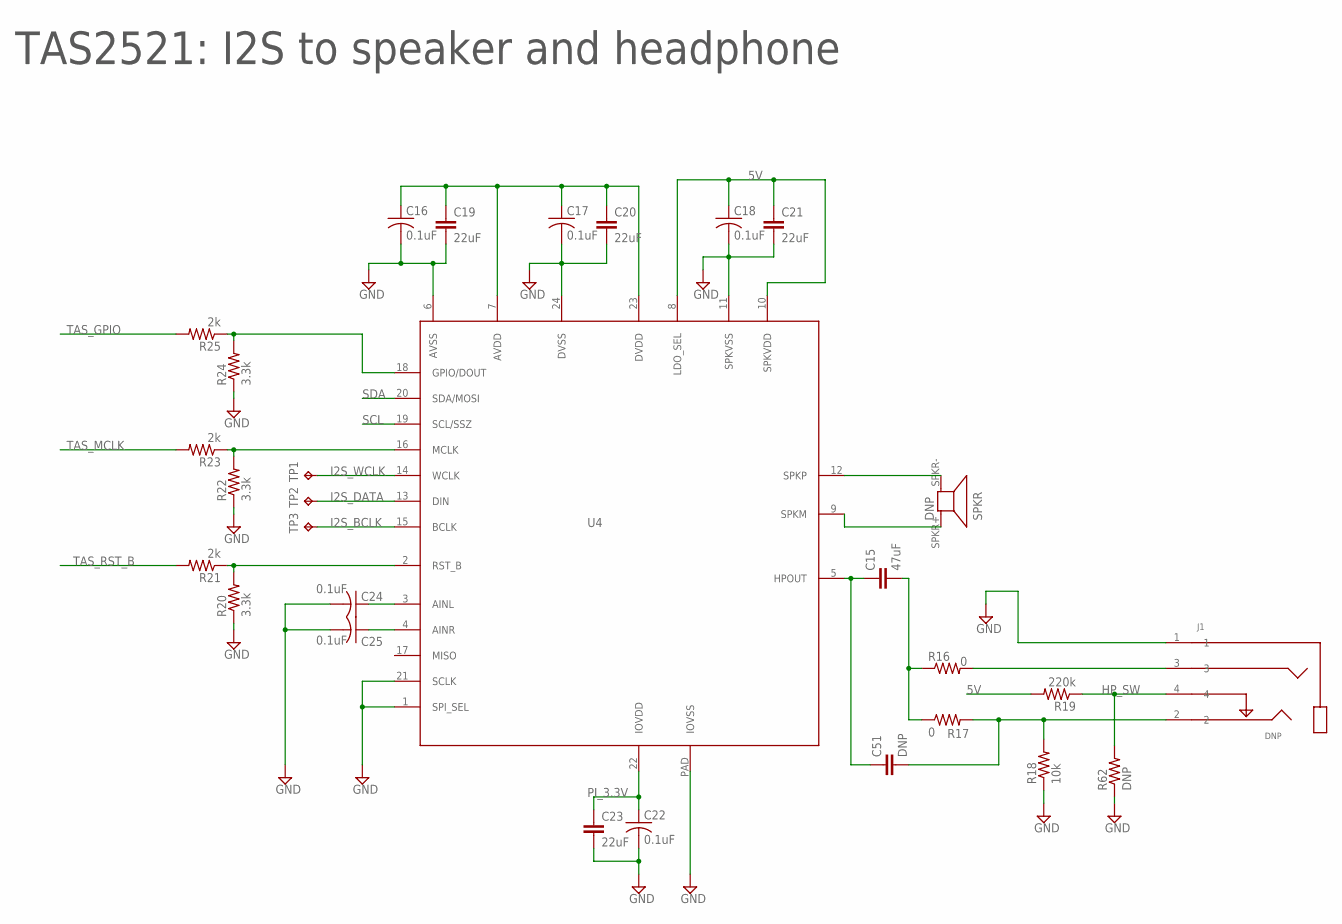
[picture p14: schematic GBA SP schematic.sch, sheet 4]

Parts:
C15: 47uF; C0805; MPN GRM21BR61A476ME15L; DIGIKEY 490-9961-1-ND
C16, C17, C18, C22, C24, C25: 0.1uF; 0402_REAL; MPN CC0603ZRY5V9BB104; DIGIKEY 311-1343-1-ND
C19, C20, C21, C23: 22uF; C0805; MPN LMK212BBJ226MG-T; DIGIKEY 587-5464-1-ND
C51: DNP; C0805; MPN GRM21BR61A476ME15L; DIGIKEY 490-9961-1-ND
J1: DNP; HEADPHONE_JACK; MPN SJ-3524-SMT; DIGIKEY CP-3524SJCT-ND
R16, R17: 0; 0402_REAL
R18: 10k; 0402_REAL
R19: 220k; R0603
R20, R22, R24: 3.3k; 0402_REAL
R21, R23, R25: 2k; 0402_REAL; MPN ERJ-2RKF2001X; DIGIKEY P2.00KLCT-ND
R62: DNP; 0402_REAL
SPKR: DNP; GBA-SPKR
TP1, TP2, TP3: TPTP06R; TP06R
U4: TAS2521; QFN24; MPN TAS2521IRGET; DIGIKEY 296-35781-1-ND

Connections:
5V: C18.1, C21.1, R19.2, U4.8 (LDO_SEL), U4.10 (SPKVDD); also elsewhere on the board
GND: C16.2, C17.2, C18.2, C19.2, C20.2, C21.2, C22.2, C23.2, C24.2, C25.2, J1.1, R18.1, R20.1, R22.1, R24.1, R62.1, U4.1 (SPI_SEL), U4.6 (AVSS), U4.11 (SPKVSS), U4.21 (SCLK), U4.24 (DVSS), U4.PAD (IOVSS); also elsewhere on the board
HP_SW: J1.4, R19.1, R62.2; also elsewhere on the board
I2S_BCLK: TP3.TP, U4.15 (BCLK); also elsewhere on the board
I2S_DATA: TP2.TP, U4.13 (DIN); also elsewhere on the board
I2S_WCLK: TP1.TP, U4.14 (WCLK); also elsewhere on the board
unnamed: SPKR.SPKR- (-), U4.12 (SPKP)
unnamed: SPKR.SPKR+ (+), U4.9 (SPKM)
unnamed: C15.1, C51.1, U4.5 (HPOUT)
unnamed: C15.2, R16.1, R17.1
unnamed: J1.3, R16.2
unnamed: C51.2, J1.2, R17.2, R18.2
unnamed: C16.1, C17.1, C19.1, C20.1, U4.7 (AVDD), U4.23 (DVDD)
unnamed: R20.2, R21.1, U4.2 (RST_B)
unnamed: R22.2, R23.1, U4.16 (MCLK)
unnamed: R24.2, R25.1, U4.18 (GPIO/DOUT)
unnamed: C24.1, U4.3 (AINL)
unnamed: C25.1, U4.4 (AINR)
PI_3.3V: C22.1, C23.1, U4.22 (IOVDD); also elsewhere on the board
SCL: U4.19 (SCL/SSZ); also elsewhere on the board
SDA: U4.20 (SDA/MOSI); also elsewhere on the board
TAS_GPIO: R25.2
TAS_MCLK: R23.2
TAS_RST_B: R21.2; also elsewhere on the board

Notes on the sheet:
TAS2521: I2S to speaker and headphone

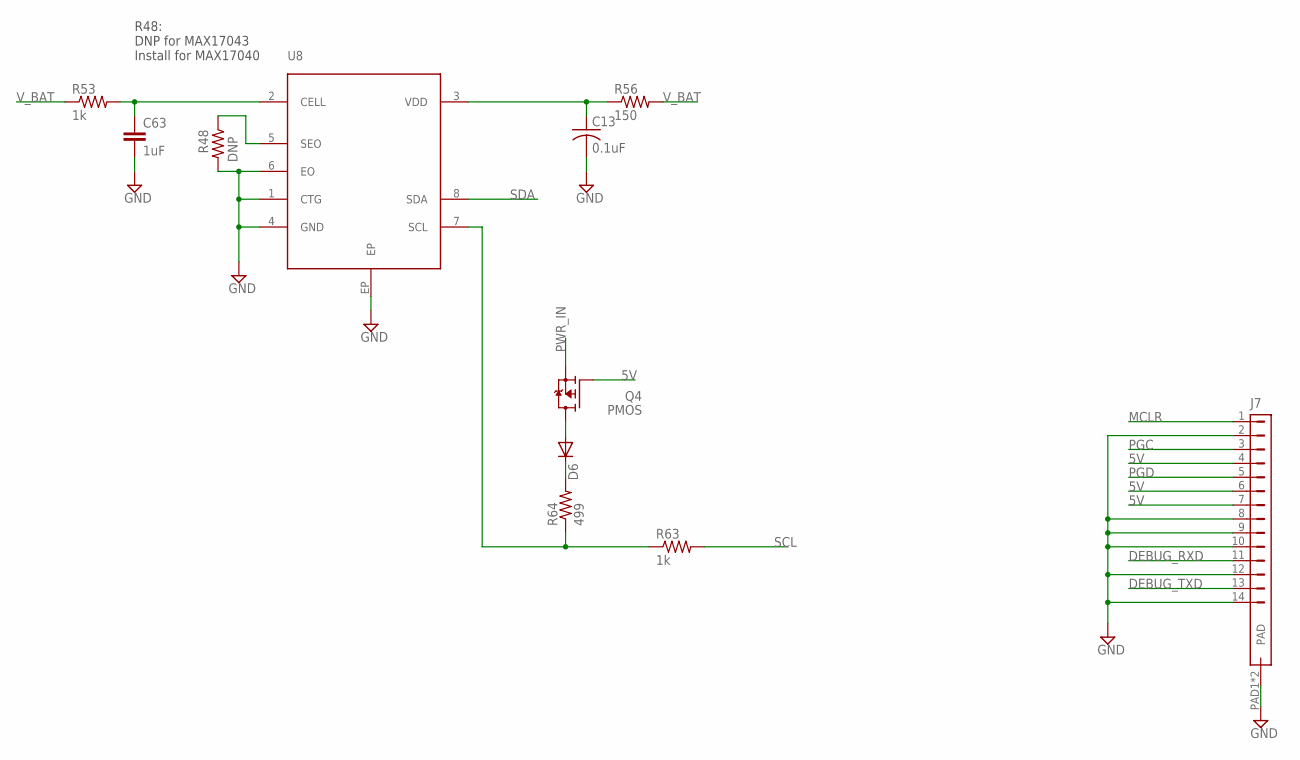
[picture p15: schematic GBA SP schematic.sch, sheet 5]

Parts:
C13: 0.1uF; 0402_REAL; MPN CC0603ZRY5V9BB104; DIGIKEY 311-1343-1-ND
C63: 1uF; 0402_REAL
D6: DIODE-SOD523; SOD523
J7: FPC_14; MPN 5051101492; DIGIKEY WM12370CT-ND
Q4: PMOS; SC70
R48: DNP; 0402_REAL
R53, R63: 1k; 0402_REAL
R56: 150; 0402_REAL
R64: 499; 0402_REAL
U8: MAX17040; TDFN-2X3; MPN MAX17043

Connections:
5V: J7.4, J7.6, J7.7, Q4.G; also elsewhere on the board
DEBUG_RXD: J7.11; also elsewhere on the board
DEBUG_TXD: J7.13; also elsewhere on the board
GND: C13.2, C63.2, J7.2, J7.8, J7.9, J7.10, J7.12, J7.14, J7.PAD1 (PAD), J7.PAD2 (PAD), R48.2, U8.1 (CTG), U8.4 (GND), U8.6 (EO), U8.EP; also elsewhere on the board
MCLR: J7.1; also elsewhere on the board
unnamed: R48.1, U8.5 (SEO)
unnamed: D6.C, R64.2
unnamed: D6.A, Q4.D
unnamed: C63.1, R53.2, U8.2 (CELL)
unnamed: C13.1, R56.1, U8.3 (VDD)
unnamed: R63.1, R64.1, U8.7 (SCL)
PGC: J7.3; also elsewhere on the board
PGD: J7.5; also elsewhere on the board
PWR_IN: Q4.S; also elsewhere on the board
SCL: R63.2; also elsewhere on the board
SDA: U8.8 (SDA); also elsewhere on the board
V_BAT: R53.1, R56.2; also elsewhere on the board

Notes on the sheet:
R48: DNP for MAX17043 Install for MAX17040

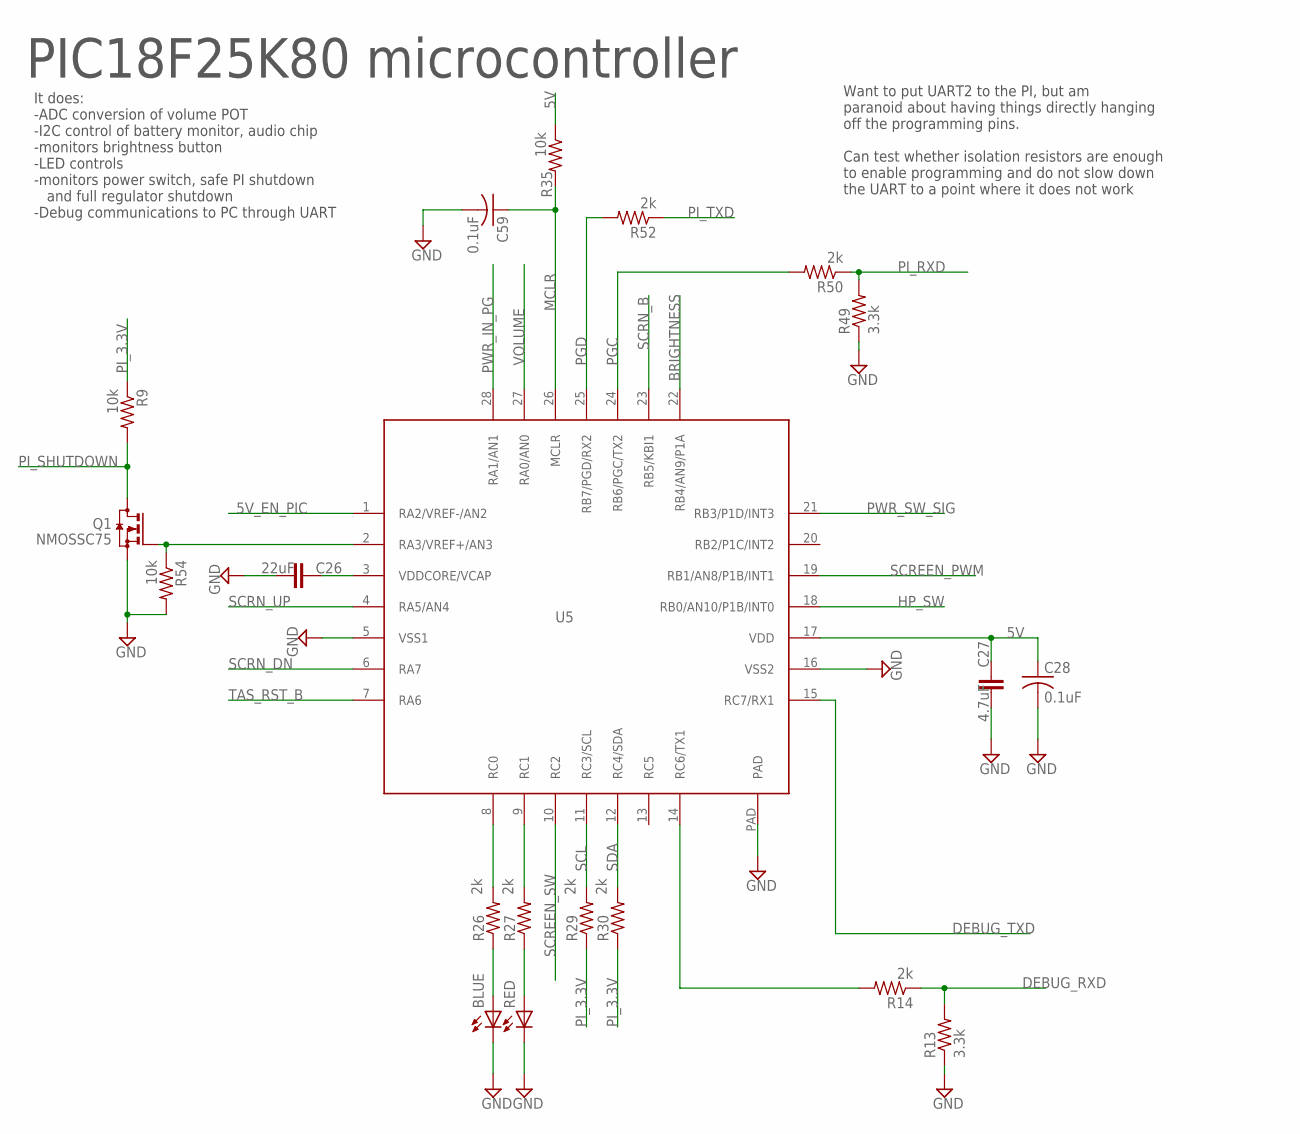
[picture p16: schematic GBA SP schematic.sch, sheet 6]

Parts:
BLUE: LEDCHIP-LED0603; CHIP-LED0603; MPN LTST-C193TBKT-5A; DIGIKEY 160-1827-1-ND
C26: 22uF; C0805; MPN LMK212BBJ226MG-T; DIGIKEY 587-5464-1-ND
C27: 4.7uF; C0603; MPN CC0603KRX5R6BB475; DIGIKEY 311-1455-1-ND
C28, C59: 0.1uF; 0402_REAL; MPN CC0603ZRY5V9BB104; DIGIKEY 311-1343-1-ND
Q1: NMOSSC75; SC75; MPN NTA4001NT1G; DIGIKEY NTA4001NT1GOSCT-ND
R9, R35, R54: 10k; 0402_REAL
R13, R49: 3.3k; 0402_REAL
R14, R26, R27, R29, R30, R50, R52: 2k; 0402_REAL; MPN ERJ-2RKF2001X; DIGIKEY P2.00KLCT-ND
RED: LEDCHIP-LED0603; CHIP-LED0603; MPN LTST-C191KRKT; DIGIKEY 160-1447-1-ND
U5: PIC18F25K80; QFN-S_28; MPN PIC18F25K80-I/MM; DIGIKEY PIC18F25K80-I/MM-ND

Connections:
5V: C27.1, C28.1, R35.1, U5.17 (VDD); also elsewhere on the board
5V_EN_PIC: U5.1 (RA2/VREF-/AN2); also elsewhere on the board
BRIGHTNESS: U5.22 (RB4/AN9/P1A); also elsewhere on the board
DEBUG_RXD: R13.2, R14.1; also elsewhere on the board
DEBUG_TXD: U5.15 (RC7/RX1); also elsewhere on the board
GND: BLUE.C, C26.2, C27.2, C28.2, C59.2, Q1.S, R13.1, R49.1, R54.2, RED.C, U5.5 (VSS1), U5.16 (VSS2), U5.PAD; also elsewhere on the board
HP_SW: U5.18 (RB0/AN10/P1B/INT0); also elsewhere on the board
MCLR: C59.1, R35.2, U5.26 (MCLR); also elsewhere on the board
unnamed: R14.2, U5.14 (RC6/TX1)
unnamed: Q1.G, R54.1, U5.2 (RA3/VREF+/AN3)
unnamed: R27.1, RED.A
unnamed: BLUE.A, R26.1
unnamed: R27.2, U5.9 (RC1)
unnamed: R26.2, U5.8 (RC0)
unnamed: C26.1, U5.3 (VDDCORE/VCAP)
PGC: R50.2, U5.24 (RB6/PGC/TX2); also elsewhere on the board
PGD: R52.2, U5.25 (RB7/PGD/RX2); also elsewhere on the board
PI_3.3V: R9.1, R29.1, R30.1; also elsewhere on the board
PI_RXD: R49.2, R50.1; also elsewhere on the board
PI_SHUTDOWN: Q1.D, R9.2; also elsewhere on the board
PI_TXD: R52.1; also elsewhere on the board
PWR_IN_PG: U5.28 (RA1/AN1); also elsewhere on the board
PWR_SW_SIG: U5.21 (RB3/P1D/INT3); also elsewhere on the board
SCL: R29.2, U5.11 (RC3/SCL); also elsewhere on the board
SCREEN_PWM: U5.19 (RB1/AN8/P1B/INT1); also elsewhere on the board
SCREEN_SW: U5.10 (RC2); also elsewhere on the board
SCRN_B: U5.23 (RB5/KBI1); also elsewhere on the board
SCRN_DN: U5.6 (RA7); also elsewhere on the board
SCRN_UP: U5.4 (RA5/AN4); also elsewhere on the board
SDA: R30.2, U5.12 (RC4/SDA); also elsewhere on the board
TAS_RST_B: U5.7 (RA6); also elsewhere on the board
VOLUME: U5.27 (RA0/AN0); also elsewhere on the board

Notes on the sheet:
PIC18F25K80 microcontroller
It does: -ADC conversion of volume POT -I2C control of battery monitor, audio chip -monitors brightness button -LED controls -monitors power switch, safe PI shutdown and full regulator shutdown -Debug communications to PC through UART
Want to put UART2 to the PI, but am paranoid about having things directly hanging off the programming pins. Can test whether isolation resistors are enough to enable programming and do not slow down the UART to a point where it does not work

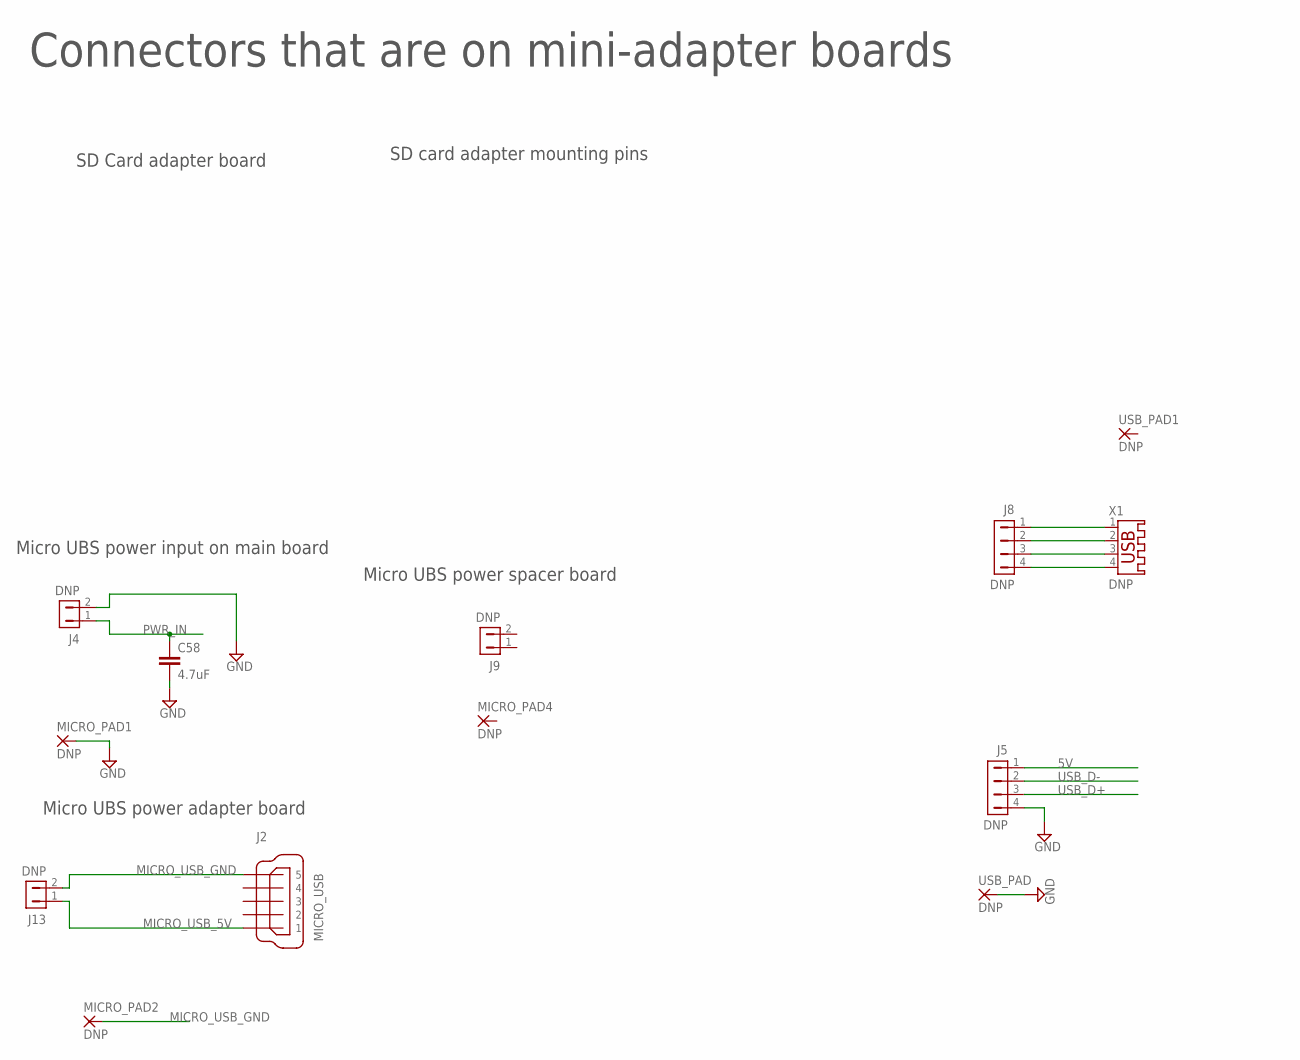
[picture p17: schematic GBA SP schematic.sch, sheet 7]

Parts:
C58: 4.7uF; C0603; MPN CC0603KRX5R6BB475; DIGIKEY 311-1455-1-ND
J2: MICRO_USB; MPN 10118192-0001LF; DIGIKEY 609-4613-1-ND
J4, J9, J13: DNP; USB_PWR_2PIN
J5, J8: DNP; USB_4PIN
MICRO_PAD1, MICRO_PAD2, MICRO_PAD4: DNP; 1,6/0,8
USB_PAD, USB_PAD1: DNP; 1,6/0,8
X1: DNP; USB-A003; MPN 87583-2010BLF; DIGIKEY 609-4413-ND

Connections:
5V: J5.1; also elsewhere on the board
GND: C58.2, J4.2, J5.4, MICRO_PAD1.1, USB_PAD.1; also elsewhere on the board
MICRO_USB_5V: J2.1, J13.1
MICRO_USB_GND: J2.5, J13.2, MICRO_PAD2.1
unnamed: J8.1, X1.1
unnamed: J8.2, X1.2
unnamed: J8.3, X1.3
unnamed: J8.4, X1.4
PWR_IN: C58.1, J4.1; also elsewhere on the board
USB_D+: J5.3; also elsewhere on the board
USB_D-: J5.2; also elsewhere on the board

Notes on the sheet:
Connectors that are on mini-adapter boards
SD Card adapter board
SD card adapter mounting pins
Micro UBS power input on main board
Micro UBS power adapter board
Micro UBS power spacer board

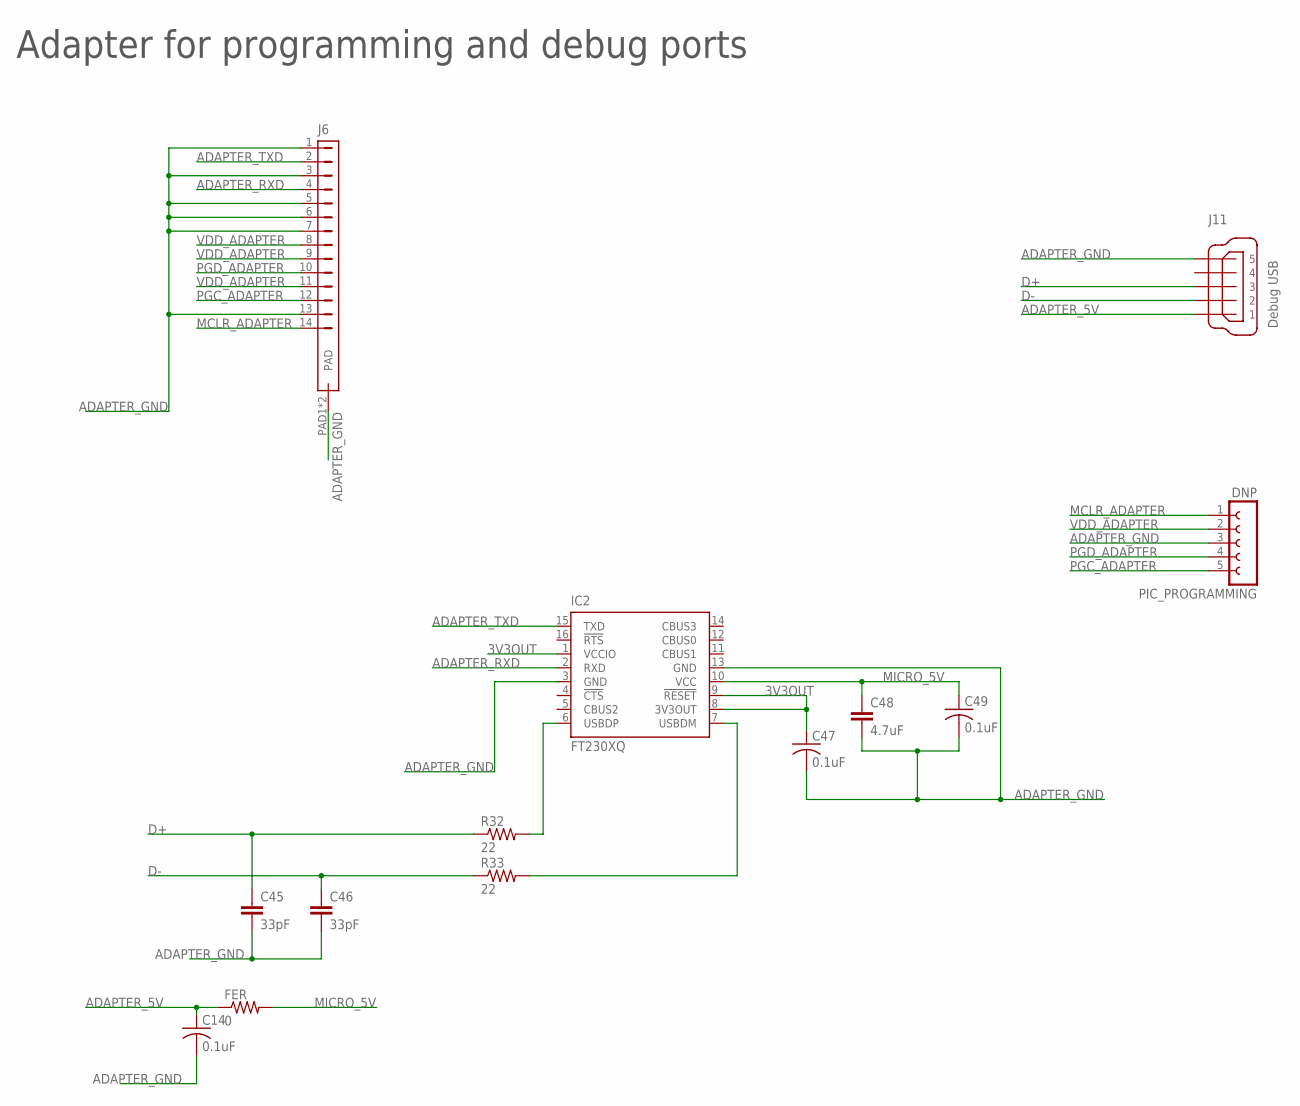
[picture p18: schematic GBA SP schematic.sch, sheet 8]

Parts:
C14, C47, C49: 0.1uF; 0402_REAL; MPN CC0603ZRY5V9BB104; DIGIKEY 311-1343-1-ND
C45, C46: 33pF; 0402_REAL
C48: 4.7uF; C0603; MPN CC0603KRX5R6BB475; DIGIKEY 311-1455-1-ND
FER: 0; R0603
IC2: FT230XQ; QFN16; MPN FT230XQ-R; DIGIKEY 768-1130-1-ND
J6: FPC_14; MPN 5051101492; DIGIKEY WM12370CT-ND
J11: Debug USB; MICRO_USB; MPN 10118192-0001LF; DIGIKEY 609-4613-1-ND
PIC_PROGRAMMING: DNP; FE05-1; MPN PPTC051LGBN-RC; DIGIKEY S5441-ND
R32, R33: 22; 0402_REAL

Connections:
3V3OUT: C47.1, IC2.1 (VCCIO), IC2.8 (3V3OUT), IC2.9 (!RESET)
ADAPTER_5V: C14.1, FER.1, J11.1
ADAPTER_GND: C14.2, C45.2, C46.2, C47.2, C48.2, C49.2, IC2.3 (GND), IC2.13 (GND), J6.1, J6.3, J6.5, J6.6, J6.7, J6.13, J6.PAD1 (PAD), J6.PAD2 (PAD), J11.5, PIC_PROGRAMMING.3
ADAPTER_RXD: IC2.2 (RXD), J6.4
ADAPTER_TXD: IC2.15 (TXD), J6.2
D+: C45.1, J11.3, R32.1
D-: C46.1, J11.2, R33.1
DM: IC2.7 (USBDM), R33.2
DP: IC2.6 (USBDP), R32.2
MCLR_ADAPTER: J6.14, PIC_PROGRAMMING.1
MICRO_5V: C48.1, C49.1, FER.2, IC2.10 (VCC)
PGC_ADAPTER: J6.12, PIC_PROGRAMMING.5
PGD_ADAPTER: J6.10, PIC_PROGRAMMING.4
VDD_ADAPTER: J6.8, J6.9, J6.11, PIC_PROGRAMMING.2

Notes on the sheet:
Adapter for programming and debug ports

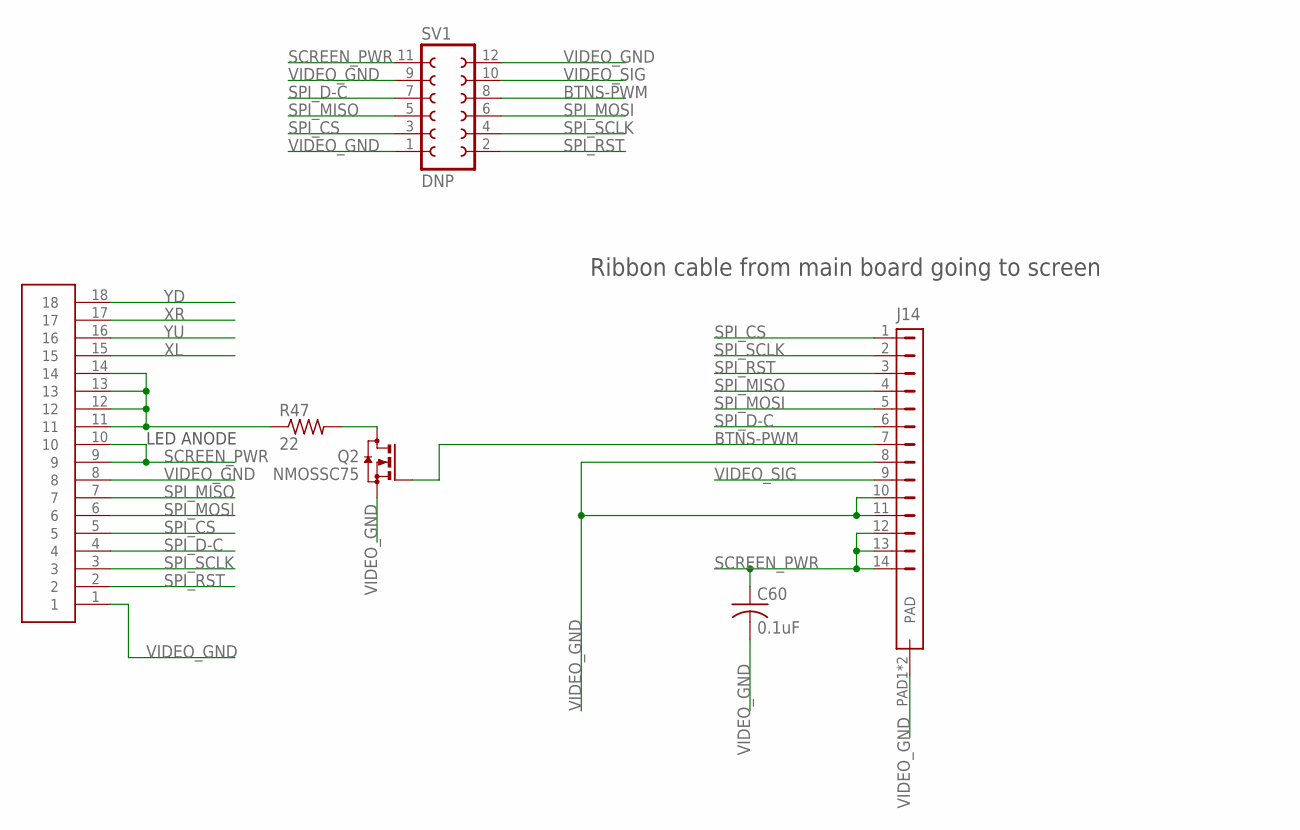
[picture p19: schematic GBA SP schematic.sch, sheet 9]

Parts:
C60: 0.1uF; 0402_REAL; MPN CC0603ZRY5V9BB104; DIGIKEY 311-1343-1-ND
J14: FPC_14; MPN 5051101492; DIGIKEY WM12370CT-ND
Q2: NMOSSC75; SC75; MPN NTA4001NT1G; DIGIKEY NTA4001NT1GOSCT-ND
R47: 22; 0402_REAL
SCREEN1: DNP; SPI_SCREEN
SV1: DNP; FE06-2

Connections:
BTNS-PWM: J14.7, Q2.G, SV1.8
K: R47.1, SCREEN1.11, SCREEN1.12, SCREEN1.13, SCREEN1.14
unnamed: Q2.D, R47.2
SCREEN_PWR: C60.1, J14.12, J14.13, J14.14, SCREEN1.9, SCREEN1.10, SV1.11
SPI_CS: J14.1, SCREEN1.5, SV1.3
SPI_D-C: J14.6, SCREEN1.4, SV1.7
SPI_MISO: J14.4, SCREEN1.7, SV1.5
SPI_MOSI: J14.5, SCREEN1.6, SV1.6
SPI_RST: J14.3, SCREEN1.2, SV1.2
SPI_SCLK: J14.2, SCREEN1.3, SV1.4
VIDEO_GND: C60.2, J14.8, J14.10, J14.11, J14.PAD1 (PAD), J14.PAD2 (PAD), Q2.S, SCREEN1.1, SCREEN1.8, SV1.1, SV1.9, SV1.12
VIDEO_SIG: J14.9, SV1.10
XL: SCREEN1.15
XR: SCREEN1.17
YD: SCREEN1.18
YU: SCREEN1.16

Notes on the sheet:
Ribbon cable from main board going to screen
LED ANODE
