codeman-pi-projects/GBA_SPi_Board/GBA SP schematic.brd

## EAGLE design GBA SP schematic.brd (continued)

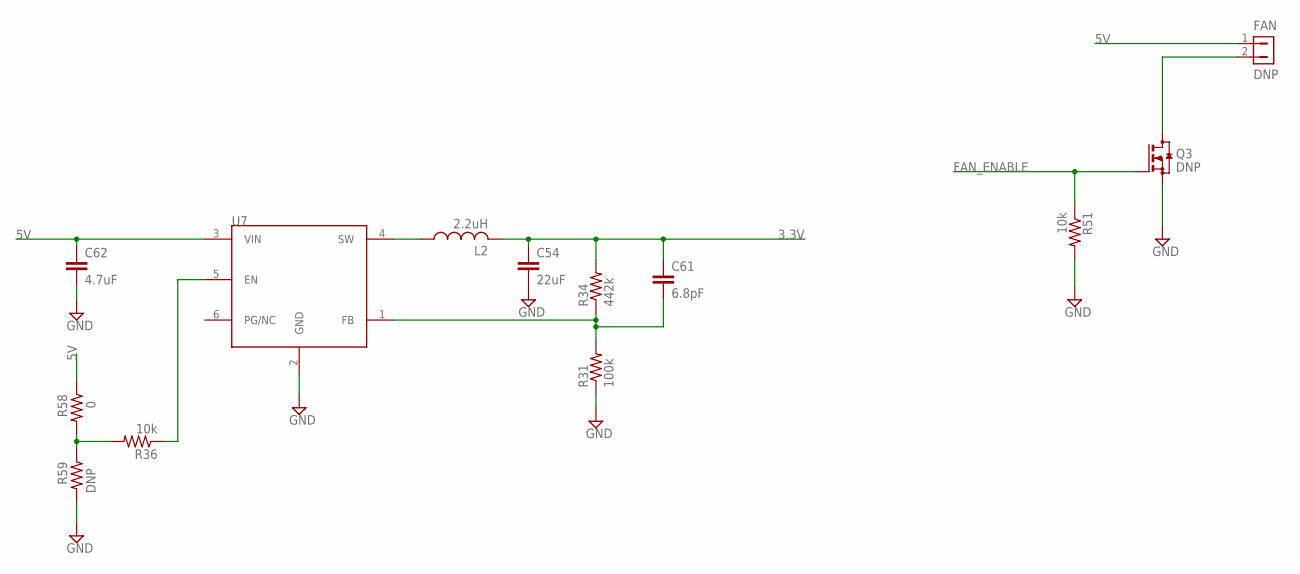
[picture p20: schematic GBA SP schematic.sch, sheet 10]

Parts:
C54: 22uF; C0805; MPN LMK212BBJ226MG-T; DIGIKEY 587-5464-1-ND
C61: 6.8pF; 0402_REAL; MPN CC0402DRNPO9BN6R8; DIGIKEY 311-1637-1-ND
C62: 4.7uF; C0603; MPN CC0603KRX5R6BB475; DIGIKEY 311-1455-1-ND
FAN: DNP; HEADER-1X2
L2: 2.2uH; L2520; MPN LQM2HPN2R2MG0L; DIGIKEY 490-5114-2-ND
Q3: DNP; TSOT23-6; MPN FDC637BNZ; DIGIKEY FDC637BNZCT-ND
R31: 100k; 0402_REAL; MPN RC0402FR-07100KL; DIGIKEY 311-100KLRCT-ND
R34: 442k; 0402_REAL; MPN RC0402FR-07442KL; DIGIKEY 311-442KLRCT-ND
R36, R51: 10k; 0402_REAL
R58: 0; 0402_REAL
R59: DNP; 0402_REAL
U7: TLV62568; SOT-563; MPN TLV62568DRLT; DIGIKEY 296-46649-1-ND

Connections:
3.3V: C54.1, C61.1, L2.2, R34.2; also elsewhere on the board
3.3V_EN: R36.1, U7.5 (EN)
5V: C62.1, FAN.1, R58.1, U7.3 (VIN); also elsewhere on the board
FAN_ENABLE: Q3.3 (G), R51.1; also elsewhere on the board
GND: C54.2, C62.2, Q3.4 (S), R31.1, R51.2, R59.2, U7.2 (GND); also elsewhere on the board
unnamed: R36.2, R58.2, R59.1
unnamed: L2.1, U7.4 (SW)
unnamed: C61.2, R31.2, R34.1, U7.1 (FB)
unnamed: FAN.2, Q3.1 (D), Q3.2 (D), Q3.5 (D), Q3.6 (D)

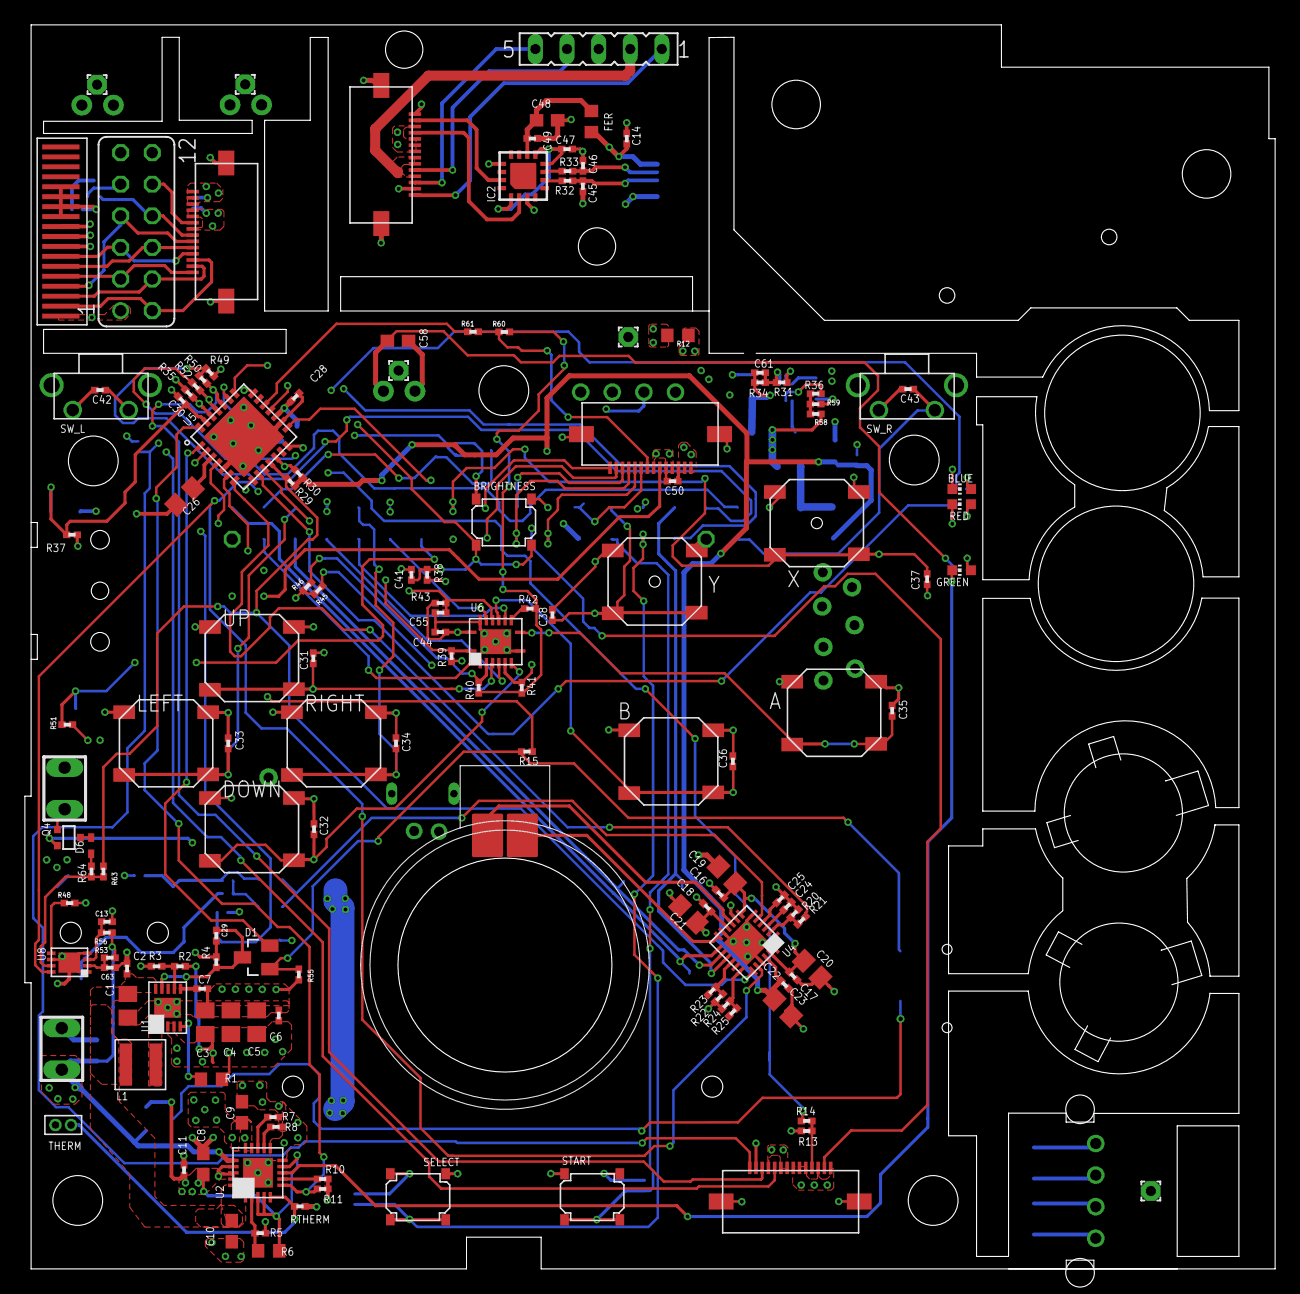
[picture p21: board GBA SP schematic.brd from above]

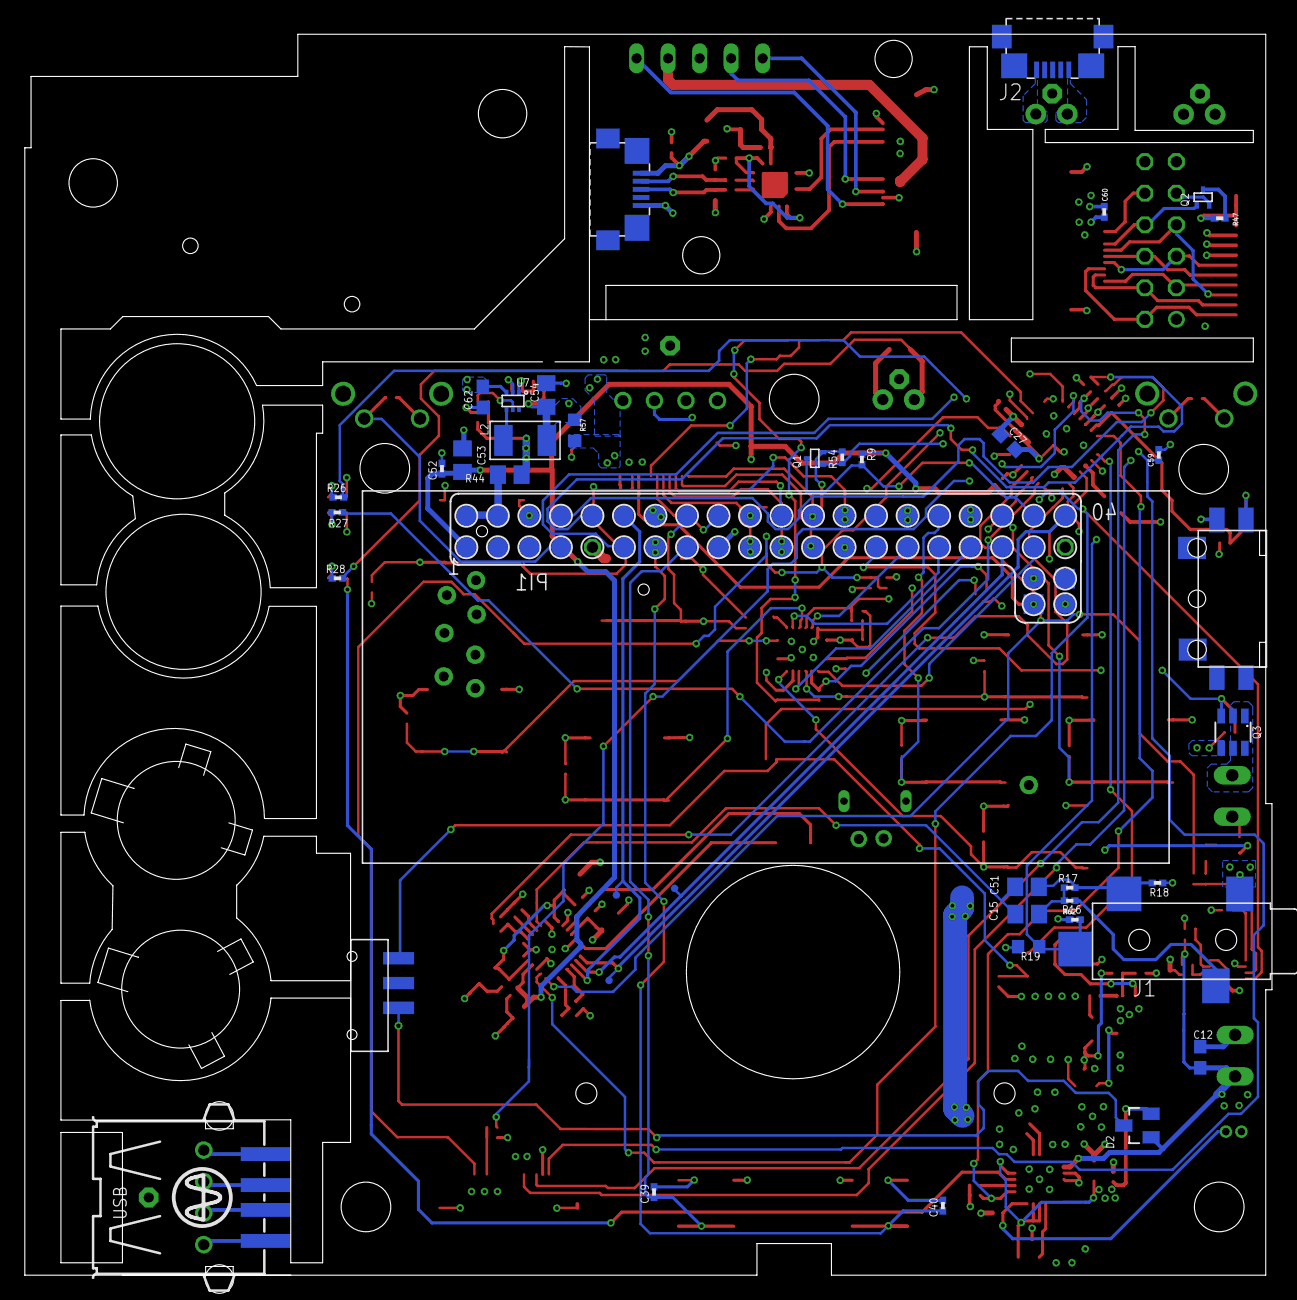
[picture p22: board GBA SP schematic.brd from below]

Board: 4 copper layers, 100.5 x 100.0 mm, 191 parts (40 on the bottom side), 139 nets.
