codeman-pi-projects/GBA_SPi_Board/Battery_monitor_fix.brd

## EAGLE design Battery_monitor_fix.brd (2018-10-26)

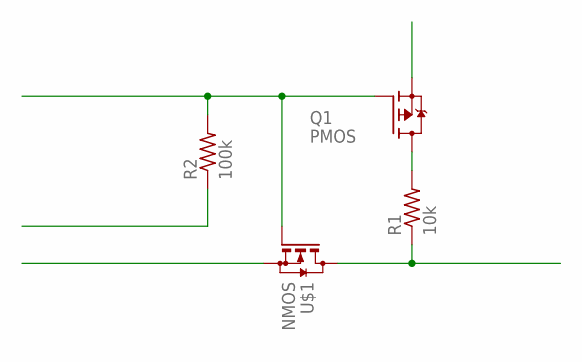
[picture p23: schematic Battery_monitor_fix.sch]

Parts:
Q1: PMOS; SC70
R1: 10k; 0402_REAL
R2: 100k; 0402_REAL
U$1: NMOS; SC70

Connections:
unnamed: Q1.G, R2.2, U$1.G
unnamed: Q1.D, R1.2
unnamed: R1.1, U$1.D

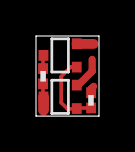
[picture p24: board Battery_monitor_fix.brd from above]

Board: 2 copper layers, 3.5 x 4.5 mm, 4 parts (0 on the bottom side), 3 nets.
