codeman-pi-projects/GBA_SPi_Board/(commit log)

2018-06-28 adding board files
    [GBA SP schematic BOM.csv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]
2018-06-28 updating BOM
    [GBA SP schematic BOM.csv]
2018-06-29 fixing BOM
    [GBA SP schematic.brd]
2018-07-06 mounting holes, fixed volume circuit
    [GBA SP schematic.sch]
2018-07-10 added volume slider holes
    [GBA SP schematic.brd]
2018-07-13 finishing board files
    [GBA SP schematic.GBL, GBA SP schematic.GBO, GBA SP schematic.GBP, GBA SP schematic.GBS, GBA SP schematic.GTL, GBA SP schematic.GTO, GBA SP schematic.GTP, GBA SP schematic.GTS]
2018-08-13 schematic pdf
2018-10-26 battery monitor fix
    [Battery_monitor_fix.GBL, Battery_monitor_fix.GBO, Battery_monitor_fix.GBP, Battery_monitor_fix.GBS, Battery_monitor_fix.GTL, Battery_monitor_fix.GTO, Battery_monitor_fix.GTP, Battery_monitor_fix.GTS]
2018-10-27 Pull-up for battery monitor
    [GBA SP schematic.brd, GBA SP schematic.sch]
